lurejewel/-/01小组展示-靳葳部分.pptx

双足机器人设计及分析

汇报人：琚振盟 李江天 张晨曦 范祖鑫 靳葳

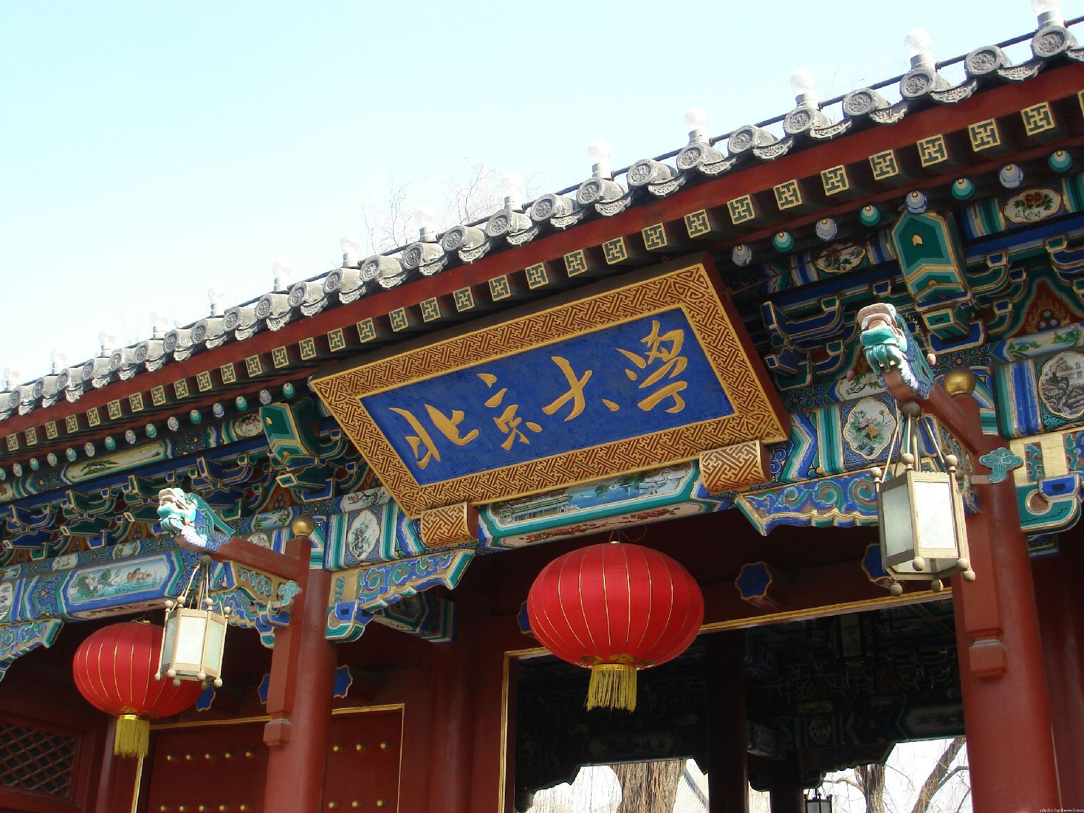
[picture p1: figure]

## Slide 2

- 机械结构设计

- ANASYS强度验证

- 运动学分析仿真

动力学建模

控制策略设计及仿真

## Slide 3

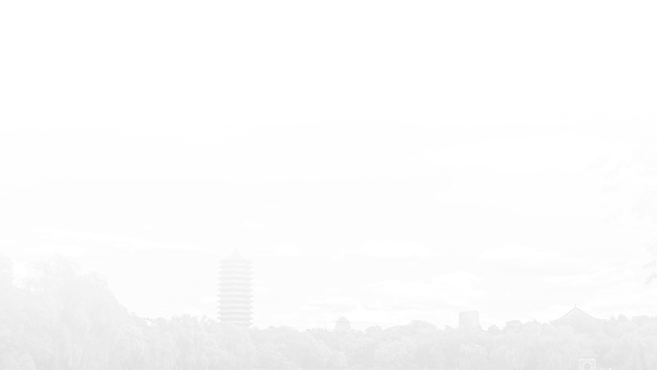
[picture p2: figure]

控制策略设计及仿真

Design of Control Strategy and Simulation

PART 05

## Slide 4

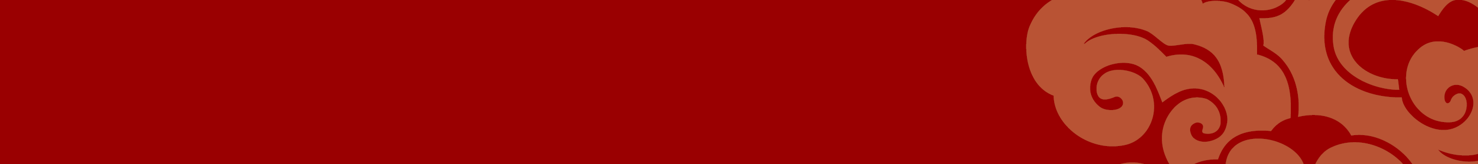
[picture p3: figure]

控制策略设计及仿真

- 基于粒子群参数实时优化的机器人关节轨迹跟踪控制

关节力矩如何给定 ?

- 基于PD的位置跟踪控制

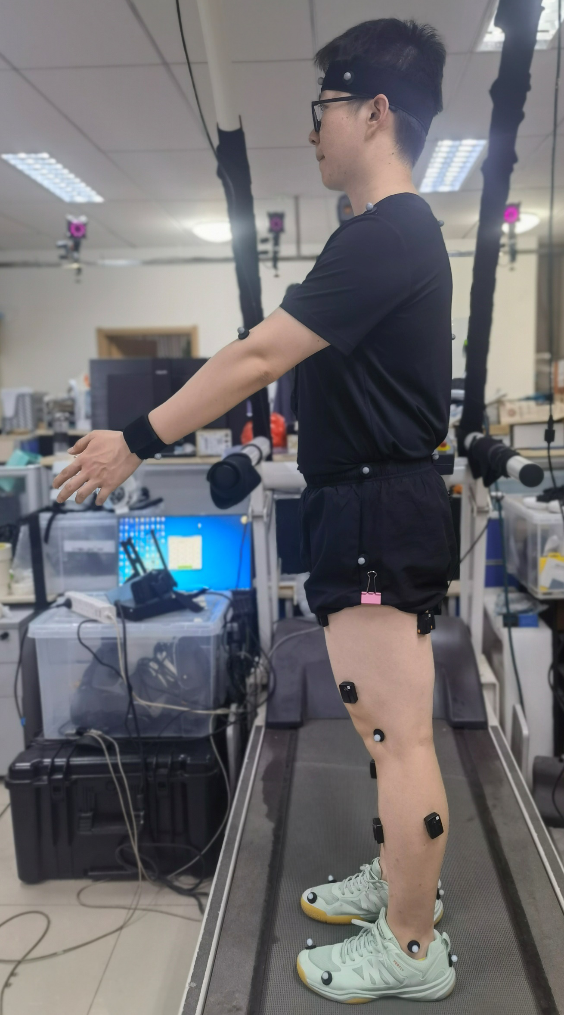
[picture p4: figure]
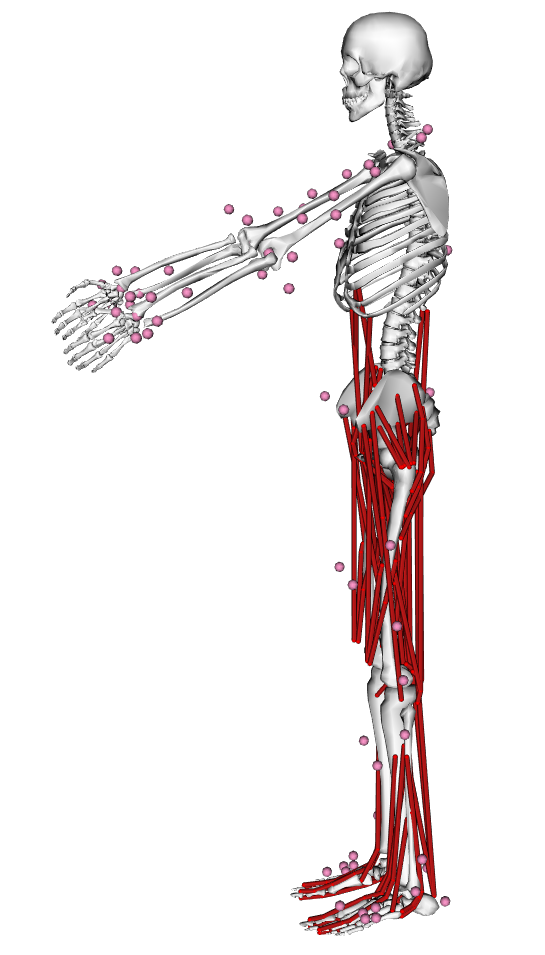
[picture p5: figure]

## Slide 5

解题思路

## 感谢倾听
