lurejewel/-/相关论文、文档参考/去年大作业参考/上肢动力外骨骼康复机器人设计-课程报告-提交版-v2.pdf

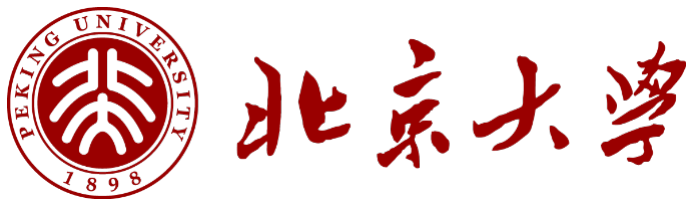
[picture p44: figure]

# 2023 年秋季学期先进机器人控制

# 课程报告

题 目： | 上肢动力外骨骼机器人设计
姓 | 名： 徐明 许诺 朱文铎 王润 孟凡旭
院 | 系： | 工学院先进制造与机器人系

2023 年 12 月

目 录

上肢动力外骨骼机器人设计

## 第 1 章 上肢外骨骼机器人整体方案设计

本章首先从人体解剖学角度分析人体上肢的结构特征与运动规律，然后提出上肢外

骨骼的设计要求。最后，基于这两方面内容确定外骨骼整体设计方案。

### 1.1 人体上肢解剖学分析

结构决定功能。上肢外骨骼机器人的作用对象为人体上肢，分析人体上肢结构，进

而确定其运动规律，对于外骨骼结构设计具有指导意义。本小节主要基于人体解剖学原

理分析人体上肢的骨骼结构与运动规律。

1.1.1 人体上肢结构

上臂

前臂

手部

腕关节

肘关节

肩关节

手指

桡骨 尺骨

肱骨

肱骨头

锁骨
肩锁关节

肩胛骨

图 1-1 人体上肢结构图

人体上肢骨骼结构如图 1-1 所示。自人体远端至人体近端，上肢由手部、前臂、上

臂三部分组成，其中，手部与前臂通过腕关节相连，前臂与上臂通过肘关节相连，上臂

与躯干通过肩关节相连。手部的指骨、前臂的桡骨与尺骨、上臂的肱骨、肩部的肩胛骨

与锁骨是主要的上肢骨骼。

肩关节、肘关节与腕关节是人体上肢的主要关节，本文所设计的外骨骼机器人不涉

及腕关节的运动训练。因此，本文重点讨论肩、肘关节的结构特征与运动规律，分别介

绍如下：

（1）肩关节：肩关节又名盂肱关节，是人体活动范围最大，活动最灵活的关节，由

肱骨头和肩胛骨的关节盂构成，为球窝式关节。肩关节可看作为一个空间球铰机构，肱

骨头绕盂肱关节转动中心有三个旋转自由度。

（2）肘关节：桡骨、尺骨上端与肱骨下端构成肘关节。肘关节为滑车式关节，具有

两个自由度。

1.1.2 人体上肢运动规律

据上文分析可知，人体上肢肩、肘关节具有五个自由度，在日常生活中使用非常频

繁，各自由度详细介绍如下：

肱骨头绕盂肱关节转动中心的三个旋转自由度分别产生上臂外展/内收、前屈/后伸

与外旋/内旋运动，如图 1-2 所示。

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
(a) 肩关节外展/内收 | (b) 肩关节前屈/后伸 | (c) 肩关节外旋/内旋

图 1-2 肩关节运动形式

肘关节的两个自由度分别产生前臂前屈/后伸、外旋/内旋运动，如图 1-3 所示。

旋转轴

前屈
后伸

旋转轴

外旋 | 内旋
(a) 肘关节前屈/后伸 | (b) 肘关节外旋/内旋

图 1-3 肘关节运动形式

此外，由于肩锁关节与胸锁关节的带动作用，在上肢运动过程中肱骨头与肩胛骨的

关节盂构成的肩关节本身会在空间内的三个方向移动，其中，移动幅度以竖直方向为最。

如肩关节在做外展运动时，会伴随着肩胛骨旋转的节律性变化，导致盂肱关节转动中心 在空间内移动，称为肩肱节律[24]。盂肱关节转动中心移动原理如图 1-4 所示。在进行上

肢外骨骼结构设计时应考虑盂肱关节转动中心在空间内的移动。

盂肱关节转动
中心(CR)
CR | CR

图 1-4 盂肱关节转动中心移动原理图

由于控制上肢实现各个运动自由度的骨骼与肌肉结构各不相同，上肢关节各自由度

的运动范围也不同。人体肩、肘关节各自由度的运动范围如表 1-1 所示。表中运动范围

测量的初始姿态为上肢平伸与肩同高，垂直于冠状面，手掌朝内与矢状面平行[25]。其中，

极限运动范围是指人体生理特征所允许的最大运动范围，功能运动范围是指日常生活中

经常用到的运动范围。

表 1-1 人体上肢肩、肘关节运动类型与运动范围

运动类型 | 极限运动范围 | 功能运动范围
肩关节 外展/内收 | 0°~105°/0°~45° | 0°~90°/0°
肩关节 前屈/后伸 | 0°~45°/0°~115° | 0°~30°/0°~90°
肩关节 外旋/内旋 | 0°~50°/0°~80° | 0°~20°/0°~75°
肘关节 前屈/后伸 | 0°~135°/0°~5° | 0°~130°/0°
肘关节 外旋/内旋 | 0°~50°/0°~50° | 0°~50°/0°~50°

### 1.2 上肢外骨骼机器人设计要求

上肢外骨骼机器人是具有特定应用场景的机械装备，为实现其功能，应根据其应用

场景与使用条件制定合理、全面的设计要求，在根本上保证机器人设计的有效性。基于

上文分析结果，现将上肢外骨骼机器人设计要求总结如下：

（1）人-机相容性：上肢外骨骼机器人带动人体上肢运动以实现运动训练，机器人

运动规律应与人体上肢自然运动规律相一致，不能引入超出人体上肢生理范围的运动，

以免对用户造成二次伤害。由于盂肱关节转动中心会在肩锁关节与胸锁关节的带动下做

复杂空间运动，在进行肩关节康复机构设计时应考虑人机相容性要求，使康复机构转动

中心自动适应肩关节转动中心的空间运动，实现关节转动中心“自动对齐”。

（2）普适性：接受上肢运动训练的用户身高、体重等特征往往个体差异较大，而进

行用户个性化设计，生产专用于某类用户的外骨骼机器人会大幅增加成本，不利于产品

推广。因此，应对上肢康复机器人进行普适性设计，研发适用于绝大部分用户的上肢外

骨骼机器人。

（3）轻量化：外骨骼是一种可穿戴式机器人，而患者的承载能力本就显著低于正常

人，这就要求机器人的本体质量应尽可能小，而且应专门设计为患肢提供重量补偿的机

械结构。

（4）安全性：上肢外骨骼机器人直接作用于人体肢体，出现故障时可能引入超出人

体生理范围的运动，轻则对患肢韧带、肌肉等组织造成一定损伤，重则可能造成骨折。

因此，应在机械结构、控制系统等多维度进行安全防护，防止意外情况发生。

### 1.3 上肢外骨骼机器人方案设计

根据人体上肢运动特征与机器人设计要求确定总体设计方案是进行上肢外骨骼机

器人设计的第一步，在整个设计周期内扮演重要角色。首先，本小节将基于上文内容确

定所设计上肢外骨骼的自由度及其分布特征；其次，根据人体上肢测量学数据确定外骨

骼主要结构参数；然后，选择合适的动力源与传动方式；最后，完成肩关节自动对心机

构与重力补偿机构的原理方案设计。

1.3.1 自由度与主要参数确定

本文旨在设计一款为肩、肘关节提供运动训练的上肢动力外骨骼，为达成这一目标，

需设置五个主动自由度，分别对应肩关节外展/内收、前屈/后伸、外旋/内旋与肘关节前

屈/后伸、外旋/内旋运动，如图 1-5 中 J1~J5所示。与此同时，考虑人机相容性要求，应

设置三个移动自由度以适应肩关节转动中心在空间内的运动，如图 1-5 中 P1~P3 所示。

P1~P3 设置为被动型，无动力源驱动，使外骨骼肩关节转动中心被动适应人体肩关节转

动中心，具体实现原理将在本节肩关节自动对心原理部分阐述。为满足普适性设计要求，

设置 P4 与 P5 用于调整杆件长度，这两个自由度在外骨骼工作时被锁定，仅在调整外骨

骼参数时起作用。外骨骼各个主动自由度的运动范围与相应人体关节的功能运动范围一

致。

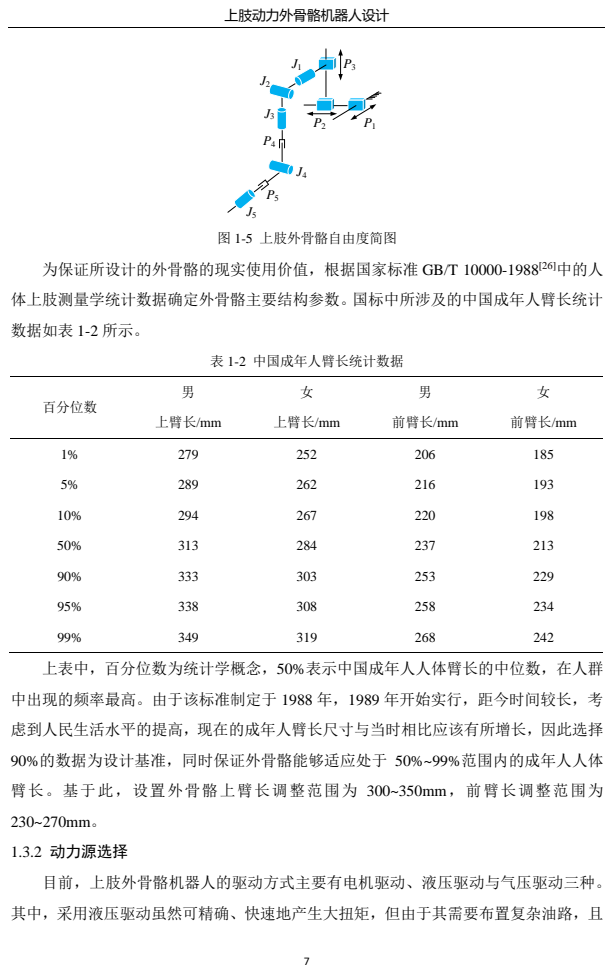
[picture p45: page 8]

为保证所设计的外骨骼的现实使用价值，根据国家标准 GB/T 10000-1988[26]中的人

上表中，百分位数为统计学概念，50%表示中国成年人人体臂长的中位数，在人群

中出现的频率最高。由于该标准制定于 1988 年，1989 年开始实行，距今时间较长，考

其中，采用液压驱动虽然可精确、快速地产生大扭矩，但由于其需要布置复杂油路，且

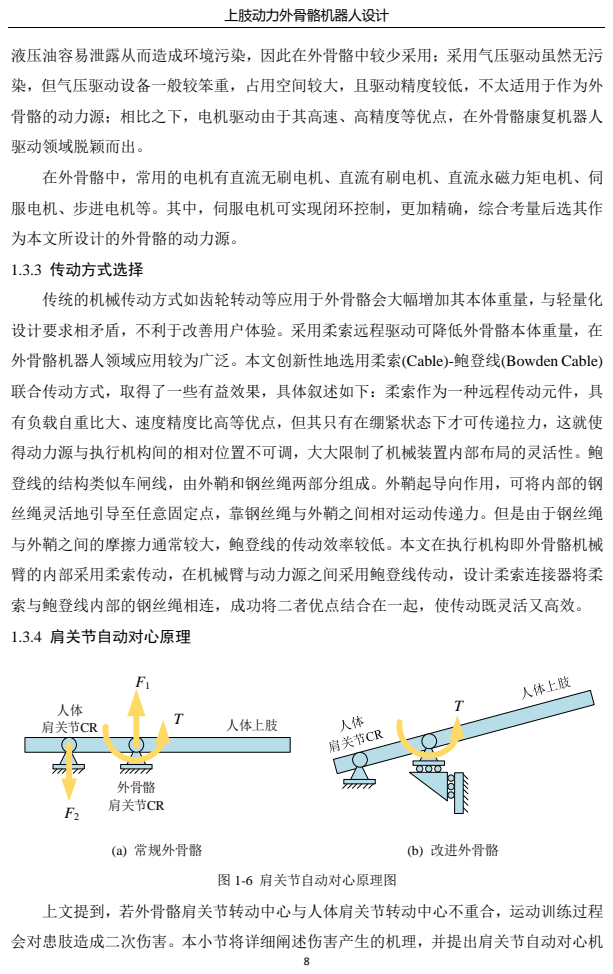
[picture p46: page 9]
驱动领域脱颖而出。; 为本文所设计的外骨骼的动力源。; 1.3.3 传动方式选择; 传统的机械传动方式如齿轮转动等应用于外骨骼会大幅增加其本体重量，与轻量化; 得动力源与执行机构间的相对位置不可调，大大限制了机械装置内部布局的灵活性。鲍; 人体上肢; 人体 肩关节CR; 外骨骼 肩关节CR; (a) 常规外骨骼; (b) 改进外骨骼; 图 1-6 肩关节自动对心原理图

液压油容易泄露从而造成环境污染，因此在外骨骼中较少采用；采用气压驱动虽然无污

染，但气压驱动设备一般较笨重，占用空间较大，且驱动精度较低，不太适用于作为外

骨骼的动力源；相比之下，电机驱动由于其高速、高精度等优点，在外骨骼康复机器人

在外骨骼中，常用的电机有直流无刷电机、直流有刷电机、直流永磁力矩电机、伺

服电机、步进电机等。其中，伺服电机可实现闭环控制，更加精确，综合考量后选其作

设计要求相矛盾，不利于改善用户体验。采用柔索远程驱动可降低外骨骼本体重量，在
外骨骼机器人领域应用较为广泛。本文创新性地选用柔索(Cable)-鲍登线(Bowden Cable)

联合传动方式，取得了一些有益效果，具体叙述如下：柔索作为一种远程传动元件，具

有负载自重比大、速度精度比高等优点，但其只有在绷紧状态下才可传递拉力，这就使

登线的结构类似车闸线，由外鞘和钢丝绳两部分组成。外鞘起导向作用，可将内部的钢

丝绳灵活地引导至任意固定点，靠钢丝绳与外鞘之间相对运动传递力。但是由于钢丝绳

与外鞘之间的摩擦力通常较大，鲍登线的传动效率较低。本文在执行机构即外骨骼机械

臂的内部采用柔索传动，在机械臂与动力源之间采用鲍登线传动，设计柔索连接器将柔

索与鲍登线内部的钢丝绳相连，成功将二者优点结合在一起，使传动既灵活又高效。
1.3.4 肩关节自动对心原理

上文提到，若外骨骼肩关节转动中心与人体肩关节转动中心不重合，运动训练过程

会对患肢造成二次伤害。本小节将详细阐述伤害产生的机理，并提出肩关节自动对心机

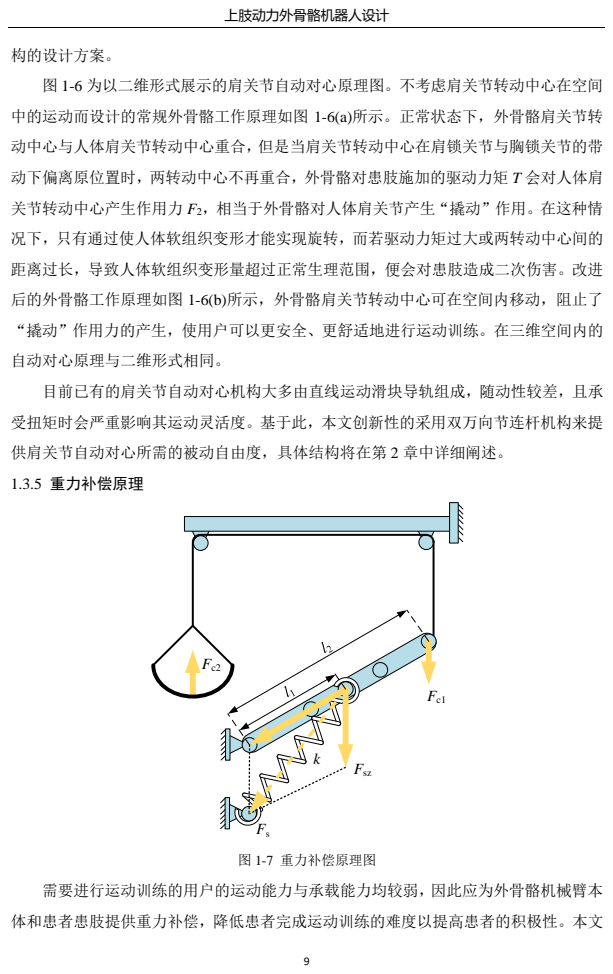
[picture p47: page 10]
构的设计方案。; 图 1-6 为以二维形式展示的肩关节自动对心原理图。不考虑肩关节转动中心在空间; 自动对心原理与二维形式相同。; 1.3.5 重力补偿原理; Fsz; 图 1-7 重力补偿原理图; 需要进行运动训练的用户的运动能力与承载能力均较弱，因此应为外骨骼机械臂本

中的运动而设计的常规外骨骼工作原理如图 1-6(a)所示。正常状态下，外骨骼肩关节转

动中心与人体肩关节转动中心重合，但是当肩关节转动中心在肩锁关节与胸锁关节的带
动下偏离原位置时，两转动中心不再重合，外骨骼对患肢施加的驱动力矩 T 会对人体肩

关节转动中心产生作用力 F2，相当于外骨骼对人体肩关节产生“撬动”作用。在这种情

况下，只有通过使人体软组织变形才能实现旋转，而若驱动力矩过大或两转动中心间的

距离过长，导致人体软组织变形量超过正常生理范围，便会对患肢造成二次伤害。改进
后的外骨骼工作原理如图 1-6(b)所示，外骨骼肩关节转动中心可在空间内移动，阻止了

“撬动”作用力的产生，使用户可以更安全、更舒适地进行运动训练。在三维空间内的

目前已有的肩关节自动对心机构大多由直线运动滑块导轨组成，随动性较差，且承

受扭矩时会严重影响其运动灵活度。基于此，本文创新性的采用双万向节连杆机构来提
供肩关节自动对心所需的被动自由度，具体结构将在第 2 章中详细阐述。

体和患者患肢提供重力补偿，降低患者完成运动训练的难度以提高患者的积极性。本文

所采用的重力补偿机构原理如图 1-7 所示。图中，弹簧的弹性系数为 k，变形量为 x，Fs

为弹簧力，Fsz 为弹簧力在竖直方向的分量，l1、l2 为杆件长度，Fc1、Fc2 为补偿力。由图

1-7 中所示几何关系，可得到式(1-1)、式(1-2)与式(1-3)。可通过改变 l1 的长度调节补偿

力的大小。

F kx s = | (1-1)

sz 1
c1
2

### Fl F

l = | (1-2)
FF c2 | c1 = | (1-3)

## 第 2 章 上肢外骨骼机器人机械结构设计

在第 1 章中只确定了外骨骼设计的原理方案，并未涉及具体机械结构的设计。本章

将承接第 1 章所讨论的外骨骼整体设计方案，完成机器人主体结构设计，并利用

## SOLIDWORKS 软件绘制三维模型。

### 2.1 外骨骼机器人结构设计

本文所设计的上肢外骨骼机器人主要由机械臂模块、肩关节自动对心模块、重力补

偿模块、动力源模块与座椅、支架等组成，整体装配效果如图 2-1 所示。本小节将分别

介绍每个模块的结构组成与装配关系。

重力补偿
模块

机械臂
模块

肩关节自动
对心模块

动力源
模块

图 2-1 外骨骼机器人整体结构图

## 2.1.1 机械臂模块

机械臂模块是本文所述的外骨骼机器人的核心模块，其直接与人体上肢相接触，是

整个机器人的执行机构。该模块由肩关节运动模块与肘关节运动模块两部分组成。

（1）肩关节运动模块：

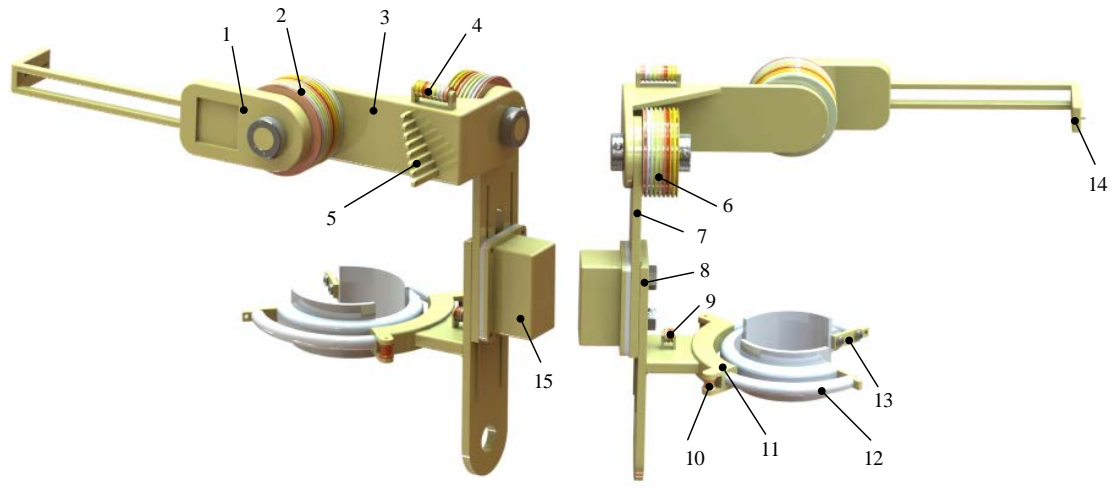
[picture p48: figure]

1 小肩板；2 滑轮组 A；3 大肩板；4 导向轮组；5 导向孔组；6 滑轮组 B；7 上臂板_固定；

8 上臂板_滑动；9 大导向轮组 A；10 小导向轮 A；11 上臂环_固定；12 上臂环_滑动；13 小垫板；

14 鲍登线固定端 A；15 螺栓罩

图 2-2 肩关节运动模块结构图

肩关节运动模块结构如图 2-2 所示，滑轮组 A(2)与小肩板(1)安装在大肩板(3)一端

的轴上，利用轴端挡圈与锁紧螺钉定位。小肩板(1)一侧设计有鲍登线固定端 A(14)，用

于固定鲍登线外鞘。滑轮组 A(2)由 9 个滑轮组成，自靠近小肩板(1)的一侧开始依次为滑

轮组 A_1 至滑轮组 A_9。其中，滑轮组 A_9 为驱动滑轮，其上有两个绳槽，滑轮通过

键与轴相连，可传递动力；其余为浮动滑轮，均只有一个绳槽，空套在轴上，只起导向

作用。大肩板(3)上设计有导向孔组(5)与导向轮支架，导向轮支架上安装有导向轮组(4)。

导向孔组(5)由 8 个导向孔组成，自靠近导向轮组(4)的一侧开始依次为导向孔_1 至导向

孔_8。导向轮组(4)由 8 个导向轮组成，自靠近滑轮组 A(2)的一侧开始依次为导向轮_1

至导向轮_8。大肩板(3)的无轴端设计有轴孔，与上臂板_固定(7)一端的短轴配合，依靠

轴端挡圈与锁紧螺钉定位。上臂板_固定(7)一端的长轴上安装有滑轮组 B(6)，利用轴端

挡圈与锁紧螺钉定位。滑轮组 B(6)由 7 个滑轮组成，自靠近大肩板(3)的一侧开始依次为

滑轮组 B_1 至滑轮组 B_7。其中，滑轮组 B_7 为驱动滑轮，其上有两个绳槽，滑轮通过

键与轴相连，可传递动力；其余为浮动滑轮，均只有一个绳槽，空套在轴上，只起导向

作用。上臂板_固定(7)上开有尺寸调整槽，两个螺栓穿过尺寸调整槽将上臂板_固定(7)与

上臂板_滑动(8)连接在一起，两者间的竖直相对位置可调。螺栓罩(15)将两个螺栓的露出

端遮挡起来，防止刮伤操作者。上臂板_滑动(8)下部固连有上臂环_固定(11)，上臂环_固

定(11)上安装有大导向轮组 A(9)与小导向轮 A(10)。大导向轮组 A(9)由两个大导向轮组

成，均位于上臂环_固定(11)的对称面上，两个小导向轮 A(10)在上臂环_固定(11)两侧对

称分布。上臂环_固定(11)与上臂环_滑动(12)的圆环面配合，上臂环_滑动(12)可沿上臂

环_固定(11)内槽滑动。上臂环_滑动(12)分内外两部分，小垫板(13)与螺钉将二者固连在

一起，上臂环_滑动(12)内侧贴附有气垫，充气后与人体上臂紧密贴合。上臂板_固定(7)

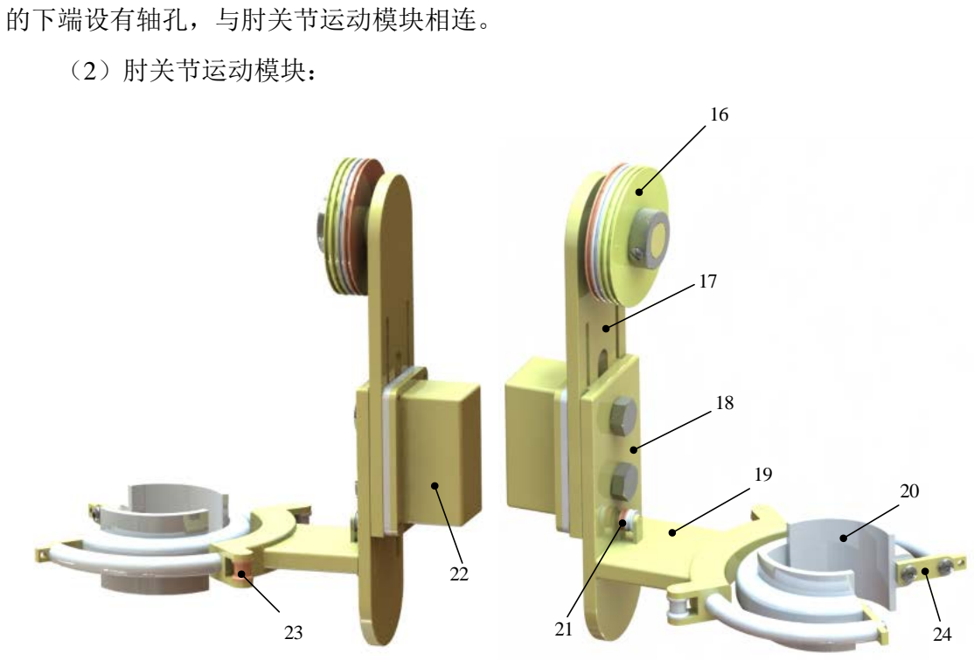
[picture p49: figure]
的下端设有轴孔，与肘关节运动模块相连。; （2）肘关节运动模块：

16 滑轮组 C；17 前臂板_固定；18 前臂板_滑动；19 前臂环_固定；20 前臂环_滑动；21 大导向轮组 B；

22 螺栓罩；23 小导向轮 B；24 小垫板

图 2-3 肘关节运动模块结构图

肘关节运动模块结构如图 2-3 所示，滑轮组 C(16)、上臂板_固定(7)的轴孔与前臂板

_固定(17)一端的轴配合，利用轴端挡圈与锁紧螺钉定位。滑轮组 C(16)由 3 个滑轮组成，

自靠近前臂板_固定(17)的一侧开始依次为滑轮组 C_1 至滑轮组 C_3。其中，滑轮组 C_3

为驱动滑轮，其上有两个绳槽，滑轮通过键与轴相连，可传递动力；其余为浮动滑轮，

均只有一个绳槽，空套在轴上，只起导向作用。前臂板_固定(17)上开有尺寸调整槽，两

个螺栓穿过尺寸调整槽将前臂板_固定(17)与前臂板_滑动(18)连接在一起，两者间的竖

直相对位置可调。螺栓罩(22)将两个螺栓的露出端遮挡起来，防止刮伤操作者。前臂板

_滑动(18)下部固连有前臂环_固定(19)，前臂环_固定(19)上安装有大导向轮组 B(21)与小

导向轮 B(23)，大导向轮组 B(21)由两个大导向轮组成，均位于前臂环_固定(19)的对称面

上，两个小导向轮 B(23)在前臂环_固定(19)两侧对称分布。前臂环_固定(19)与前臂环_

滑动(20)的圆环面配合，前臂环_滑动(20)可沿前臂环_固定(19)内槽滑动。前臂环_滑动

(20)分内外两部分，小垫板(24)与螺钉将二者固连在一起，前臂环_滑动(20)内侧贴附有

气垫，充气后与人体前臂紧密贴合。

2.1.2 肩关节自动对心模块

肩关节自动对心模块为双万向节连杆机构，结构如图 2-4 所示。连杆 A(25)一端与

小肩板(1)固连，另一端通过十字轴 A(26)与连杆 B(27)的一端连接在一起，连杆 B(27)的

另一端通过十字轴 B(28)与连杆 C(29)的一端相连，连杆 C(29)的另一端固定在支架上。

连杆 C(29)与支架相连的一端为整个机构的固定端，连杆 A(25)与小肩板(1)相连的一端

为机构末端。其末端工作空间为两球面所夹区域，半径由连杆 A(25)与连杆 B(27)的长度

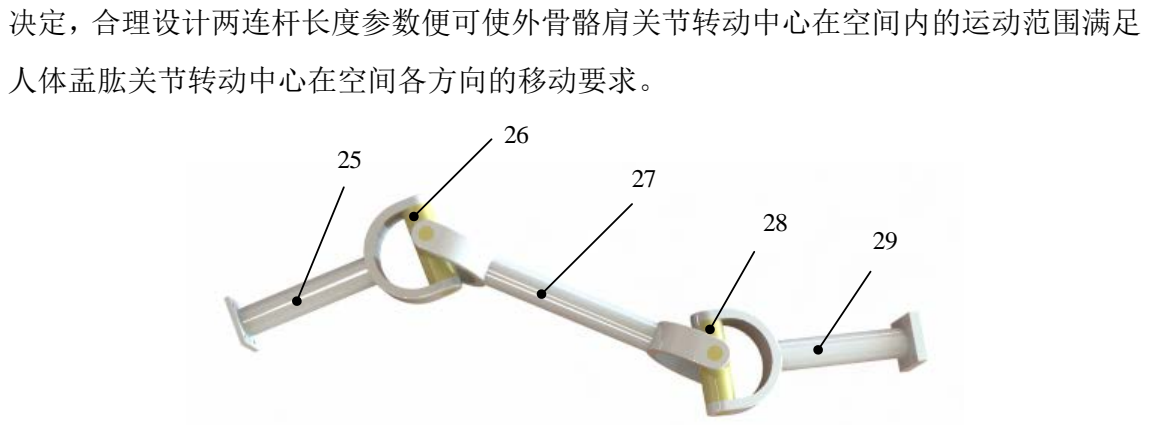
[picture p50: figure]
决定，合理设计两连杆长度参数便可使外骨骼肩关节转动中心在空间内的运动范围满足; 人体盂肱关节转动中心在空间各方向的移动要求。

25 连杆 A；26 十字轴 A；27 连杆 B；28 十字轴 B；29 连杆 C

图 2-4 肩关节自动对心模块结构图

2.1.3 重力补偿模块

重力补偿模块结构如图 2-5 所示，重力补偿杆(31)一端与支架(32)铰接，另一端设计

有柔索固定环。弹簧(30)一端固定在支架(32)上，另一端与重力补偿杆(31)上的卡槽之一

相连。大滑轮 A(33)与大滑轮 B(34)安装在支架(32)上。柔索一端固定在重力补偿杆(31)

的柔索固定环上，经大滑轮 A(33)与大滑轮 B(34)导向后与小肩板(1)相连，通过弹簧变

形产生的拉力为外骨骼提供重力补偿。

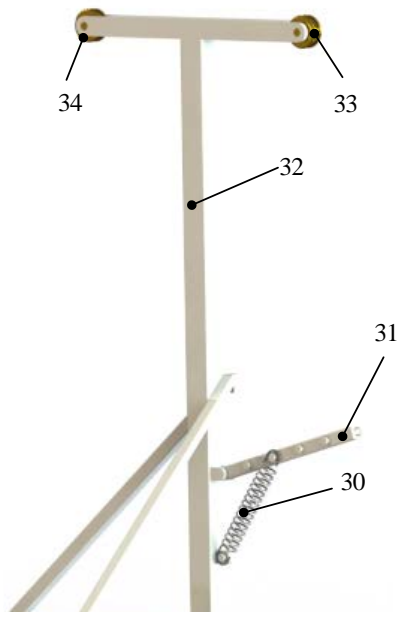
[picture p51: figure]

30 弹簧；31 重力补偿杆；32 支架；33 大滑轮 A；34 大滑轮 B

图 2-5 重力补偿模块结构图

## 2.1.4 动力源模块

动力源模块共有五组，平行布置安装在支架(32)上，结构均如图 2-6 所示。伺服电

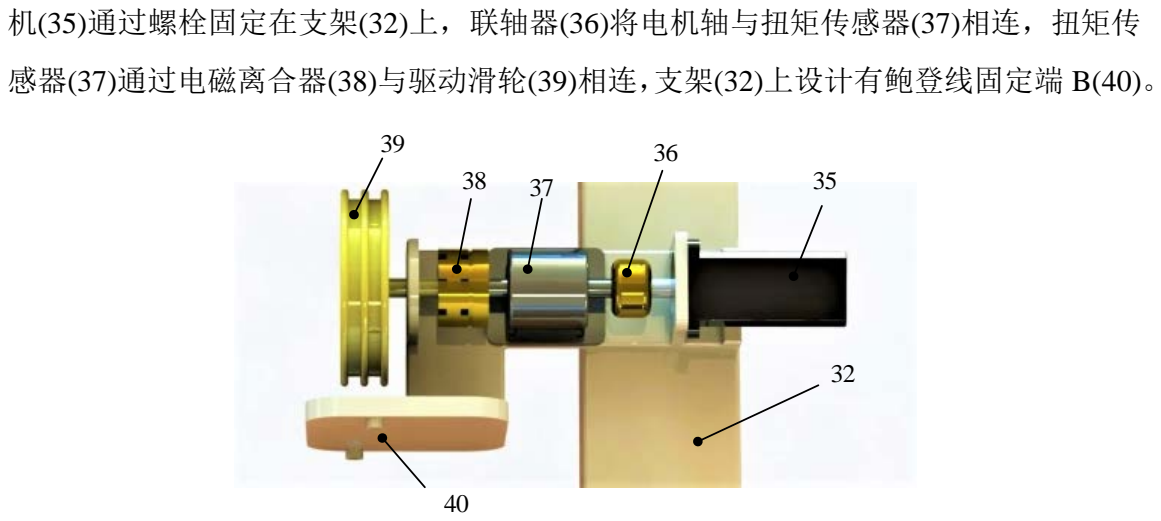
[picture p52: figure]
机(35)通过螺栓固定在支架(32)上，联轴器(36)将电机轴与扭矩传感器(37)相连，扭矩传; 感器(37)通过电磁离合器(38)与驱动滑轮(39)相连，支架(32)上设计有鲍登线固定端 B(40)。

32 支架；35 伺服电机；36 联轴器；37 扭矩传感器；38 电磁离合器；39 驱动滑轮；40 鲍登线固定端 B

图 2-6 动力源模块结构图

2.1.5 机器人整体装配效果

上肢外骨骼机器人整体装配效果如图 2-7 所示。

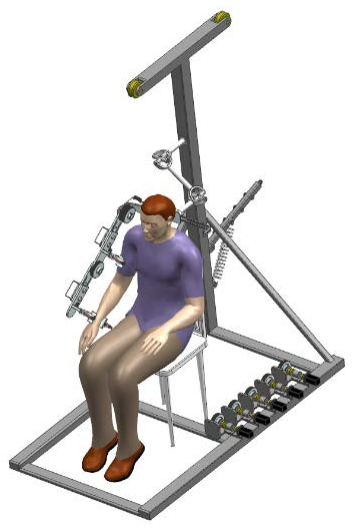
[picture p53: figure]
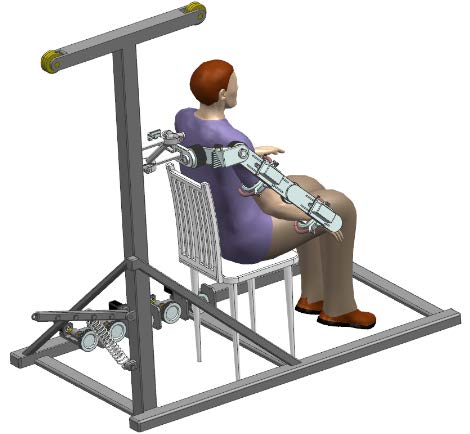
[picture p54: figure]

图 2-7 机器人整体装配效果图

### 2.2 传动策略与实施方式

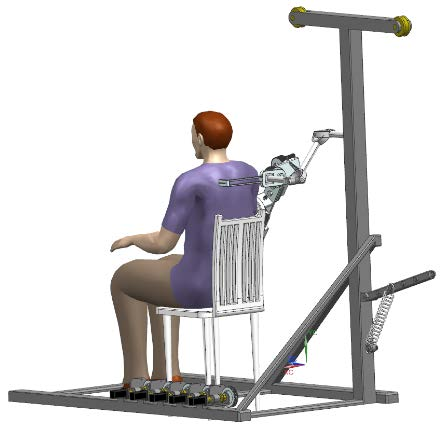
[picture p55: figure]

本文所设计的上肢外骨骼采用柔索-鲍登线联合传动，柔索与鲍登线内部的钢丝绳

直径不同，因此需设计柔索连接器将二者相连。柔索连接器结构如图 2-8 所示，鲍登线

内部钢丝绳(41)与柔索(45)末端分别装有大卡环(42)与小卡环(44)，利用两个连接挡板(46)

和四个螺钉将大卡环(42)与小卡环(44)分别固定在连接架(43)的两端。柔索连接器在装配

体中位于滑轮组 A(2)与鲍登线固定端 A(14)之间。

42 41

43

44
45

46

41 鲍登线内部钢丝绳；42 大卡环；43 连接架；44 小卡环；45 柔索；46 连接挡板

图 2-8 柔索连接器结构图

该外骨骼具有五个主动自由度，而柔索与鲍登线均单向提供拉力，因此需要十根柔

索与十根鲍登线传动，分别驱动外骨骼的五个主动关节正反旋转。根据各关节提供运动

训练形式的不同，分以下五部分介绍传动装置的布置与具体实施方式。

（1）肩关节外展/内收训练：滑轮组 A_9 的两个绳槽上分别固连有一根柔索，两根

柔索通过柔索连接器分别与两根鲍登线内部的钢丝绳相连，鲍登线外鞘的一端固定在鲍

登线固定端 A(14)处，另一端固定在第一组动力源的鲍登线固定端 B(40)处，两根鲍登线

内部钢丝绳在外鞘的引导下分别与该组动力源的驱动滑轮(39)上的两个绳槽相连，该组

动力源的伺服电机(35)正反转时分别实现肩关节外展与内收训练。

（2）肩关节前屈/后伸训练：滑轮组 B_7 的两个绳槽上分别固连有一根柔索，其中

一根柔索经导向轮_1、导向孔_1 与滑轮组 A_1 导向后通过柔索连接器与一根鲍登线内

部的钢丝绳相连；另一根柔索经导向轮_2、导向孔_2 与滑轮组 A_2 导向后通过柔索连

接器与另一根鲍登线内部的钢丝绳相连；鲍登线外鞘的一端固定在鲍登线固定端 A(14)

处，另一端固定在第二组动力源的鲍登线固定端 B(40)处，两根鲍登线内部钢丝绳在外

鞘的引导下分别与该组动力源的驱动滑轮(39)上的两个绳槽相连，该组动力源的伺服电

机(35)正反转时分别实现肩关节前屈与后伸训练。

（3）肩关节内旋/外旋训练：上臂环_滑动(12)上的两个小垫板(13)上分别固定有一

根柔索，其中一根柔索经小导向轮 A(10)、大导向轮 A(9)、滑轮组 B_6、导向轮_3、导

向孔_3 与滑轮组 A_3 导向后通过柔索连接器与一根鲍登线内部的钢丝绳相连；另一根

柔索经小导向轮 A(10)、大导向轮 A(9)、滑轮组 B_5、导向轮_4、导向孔_4 与滑轮组 A_4

导向后通过柔索连接器与另一根鲍登线内部的钢丝绳相连；鲍登线外鞘的一端固定在鲍

登线固定端 A(14)处，另一端固定在第三组动力源的鲍登线固定端 B(40)处，两根鲍登线

内部钢丝绳在外鞘的引导下分别与该组动力源的驱动滑轮(39)上的两个绳槽相连，该组

动力源的伺服电机(35)正反转时分别实现肩关节内旋与外旋训练。

（4）肘关节前屈/后伸训练：滑轮组 C_3 的两个绳槽上分别固连有一根柔索，其中

一根柔索经滑轮组 B_4、导向轮_5、导向孔_5 与滑轮组 A_5 导向后通过柔索连接器与

一根鲍登线内部的钢丝绳相连；另一根柔索经滑轮组 B_3、导向轮_6、导向孔_6 与滑轮

组 A_6 导向后通过柔索连接器与另一根鲍登线内部的钢丝绳相连；鲍登线外鞘的一端

固定在鲍登线固定端 A(14)处，另一端固定在第四组动力源的鲍登线固定端 B(40)处，两

根鲍登线内部钢丝绳在外鞘的引导下分别与该组动力源的驱动滑轮(39)上的两个绳槽相

连，该组动力源的伺服电机(35)正反转时分别实现肘关节前屈与后伸训练。

（5）肘关节内旋/外旋训练：前臂环_滑动(20)上的两个小垫板(24)上分别固定有一

根柔索，其中一根柔索经小导向轮 B(23)、大导向轮 B(21)、滑轮组 B_2、导向轮_7、导

向孔_7 与滑轮组 A_7 导向后通过柔索连接器与一根鲍登线内部的钢丝绳相连；另一根

柔索经小导向轮 B(23)、大导向轮 B(21)、滑轮组 B_1、导向轮_8、导向孔_8 与滑轮组

A_8 导向后通过柔索连接器与另一根鲍登线内部的钢丝绳相连；鲍登线外鞘的一端固定

在鲍登线固定端 A(14)处，另一端固定在第五组动力源的鲍登线固定端 B(40)处，两根鲍

登线内部钢丝绳在外鞘的引导下分别与该组动力源的驱动滑轮(39)上的两个绳槽相连，

该组动力源的伺服电机(35)正反转时分别实现肘关节内旋与外旋训练。

## 第 3 章 机械臂运动学分析与仿真

运动学分析是不考虑力和力矩对机构的影响，仅在几何角度分析机械结构运动特性

的研究方法，是机器人可行性验证的重要环节。机器人运动学分析分为正运动学分析与

逆运动学分析两部分。其中，正运动学分析是指已知机器人各关节运动参数，求解机器

人末端执行器的位置和姿态；与之相反，逆运动学分析是已知末端位置和姿态进而求解 达到这一位置和姿态时各关节的运动参数[27]。本文利用 1955 年 Denavit 与 Hartenberg 提

出的标准 D-H 参数法进行上肢外骨骼机械臂正、逆运动学理论分析，并借助 MATLAB

Robotics Toolbox 完成仿真验证。人体盂肱关节转动中心在空间的移动范围与人体上肢

的活动范围相比很小，可以忽略不计，因此，在本章及后面的章节中仅以外骨骼机械臂

为研究对象，忽略肩关节自动对心机构的影响。

### 3.1 运动学理论分析

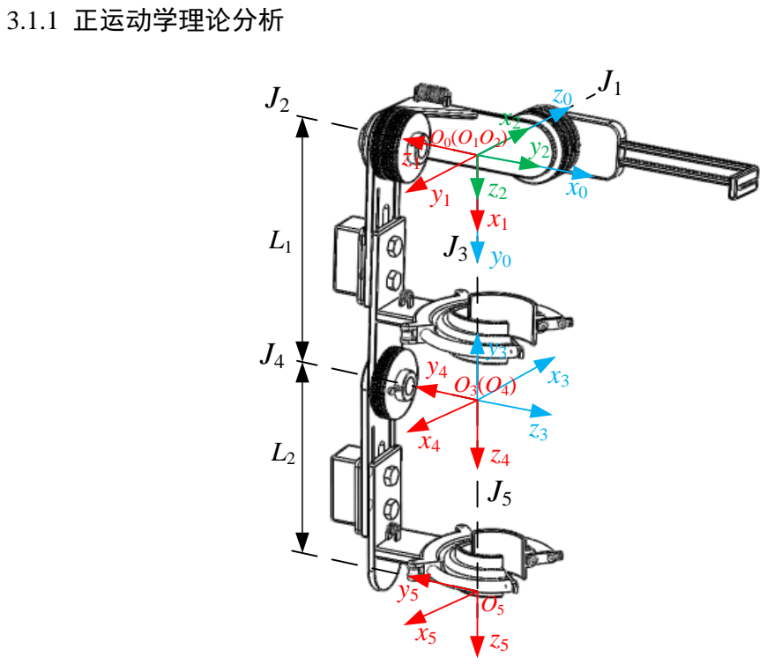
[picture p56: figure]
3.1.1 正运动学理论分析 J1 J2

图 3-1 机器人 D-H 坐标系

首先，基于 D-H 参数法建立如图 3-1 所示的坐标系。其中，{0}系为基座坐标系，

{1}至{4}系为关节坐标系，{5}系为末端工具坐标系；{0}系、{1}系与{2}系的坐标原点

均位于肩关节转动中心处，{3}系与{4}系的坐标原点位于肘关节转动中心处，{5}系的坐

标原点位于腕关节转动中心处；J1~J5 为机械臂的五个旋转轴，依次对应肩关节外展/内

收、前屈/后伸、外旋/内旋与肘关节前屈/后伸、外旋/内旋训练；L1为机械臂上臂长，L2

为机械臂前臂长。

根据标准 D-H 参数法坐标系建立原则，{i}系是由{i-1}系先绕 zi-1 轴旋转θi，再沿 zi-

1 轴平移 di，然后沿 xi轴平移 ai，最后绕 xi 轴旋转αi 得到的。因此，从{i-1}系到{i}系的

齐次变换矩阵如式(3-1)所示。
1 | Rot( , )Trans( , )Trans( , )Rot( , ) 1 | 1
00100 0 100 | 1 0 | 0 0
00010 0 010 0 0 | 0
0 | 0 10001 | 001 0 0 | 0
0 | 0 01000 1 000 1 0 0 | 0 1

i
i | i | i | i | i | i | i | i | i
i | i | i
i | i | i
i | i | i
i | i | i | i
z | z d | xa | x
c | s | a
s | c | c | s
d | s | c
c | cs | s
θ | α
θ | θ
θ | θ | α | α
| | α | α
θ | αθ α
− | = | − | −
- | − | | | | | | | | − = | | | | | | | | | | | | | | | |

−

=

T

0
0 | 0 | 0 | 1
i | i | i
i | i | i | i | i | i | i
i | i
| | | s | | ac
s | c c | s c | as
s | c | d
| | | | θ | | θ
θ αθ | αθ | θ
| α | | α
- −

(3-1)

上式中，θi 表示关节转角，di 表示关节偏移，ai 表示杆件长度，αi 表示杆件扭角，

sθi =sinθi，cθi =cosθi。为简化矩阵，下文均用 sθi 代表 sinθi, cθi 代表 cosθi。

然后，根据各坐标系之间的关系与机械臂结构设计参数确定 D-H 参数表，如表 3-1

所示。其中，括号内的数据为机器臂处于图 3-1 所示状态时的关节转角θi 的取值。

将表 3-1 所示数据代入式(3-1)可得到相邻坐标系间的齐次变换矩阵，如式(3-2)所示。

2

1 | 1 | 2 | 2
0 | 1 1 | 1 | 2
1 | 2
3 | 3 | 4 | 4
2 | 3 3 | 3 | 4 | 4
3 | 4
1
| 5 | 5
4 | 5 | 5
5
2
0 | | 0 | 0 | 0
0 | | 0 | 0 | 0
0 | 100 | 0 | 100
00 | 01 | 00 | 01
0 | | 0 | 0 | 0
0 | | 0 | 0 | 0
0 | 10 | 0 | 100
00 | 0 | 1 | 00 | 01
| | | 00
| | | 00
0 | 01
0 | 00
c | s | c | s
s | c | s | c
c | s | c | s
s | c | s | c
L
c | s
s | c
L
θ | θ | θ | θ
θ | θ | θ | θ
θ | θ | θ | θ
θ | θ | θ | θ
θ | θ
θ | θ
- | − | | −
= | = − | −
- | − | − | | | | |
= | | = | | − | − | | | | | | | |

−

=

T T

T T

T
1

(3-2)

表 3-1 机器人 D-H 参数表

杆件 i | 关节转角θi | 关节偏移 di | 杆件长度 ai | 杆件扭角αi | θi 变化范围
1 | θ1(90°) | 0 | 0 | -90° | 90°~210°
2 | θ2(-90°) | 0 | 0 | -90° | -120°~0°
3 | θ3(0°) | L1 | 0 | -90° | -75°~20°
4 | θ4(180°) | 0 | 0 | -90° | 50°~180°
5 | θ5(0°) | L2 | 0 | 0 | -50°~50°

根据矩阵的性质，由式(3-2)可求得从基坐标系{0}系到末端工具坐标系{5}系的齐次

变换矩阵 0

## T5，如式(3-3)所示。

0 | 01 | 2 | 3 | 4
5 | 12 | 3 | 4 | 5
0001
x | x | x | x
y | y | y | y
z | z | z | z

### noa p noa p noa p

= | = |
T TT T T T | (3-3)

上式中：
( ( | ) | ) | ( | )
( | ) | ( ( | ) | )
( | )
( ( | ) | ) | ( | )
5 | 4 | 13 | 12 3 | 12 4 | 5 | 31 | 123
5 | 13 | 213 | 5 | 4 | 13 | 2 31 | 12 4
5 | 24 | 342 | 235
5 | 4 | 13 | 12 3 | 12 4 | 5 | 31 | 123

x

y

z

x

y

n c c ss | ccc | cs s | s cs | cc s
n s cc | c ss | c c cs | ccs | ss s
n c cs | ccs | sss
o | s c ss | ccc | cs s | c cs | cc s
o
θ θ θθ θθ θ | θθ θ | θ θθ θθ θ
θ θθ θ θθ | θ θ θθ θ θθ | θθ θ
θ θθ θθθ | θθθ
θ θ θθ θθ θ | θθ θ | θ θθ θθ θ
= | + | + | − | −
= | + | − | − | −
= | − | −
=− | + | + | − | −
( ( | ) | ) | ( | )
( | )
( | )
( | )
( | )
5 | 4 | 13 | 2 31 | 12 4 | 5 | 13 | 213
5 | 24 | 342 | 523
142 | 4 | 13 | 123
4 | 13 | | 2 31 | 412
2 | 4 | 324
2 | 4 | 13 | 123 | 1

z

x

y

z

x

s c cs | ccs | ss s | c cc | c ss
o | s cs | ccs | css
a cc s | s ss | ccc
a s cs | ccs | css
a cc | css
p | L s ss | ccc | cc
θ θ θθ θ θθ | θθ θ | θ θθ θ θθ
θ θθ θθθ | θθθ
θθ θ θ θθ θθ θ
θ θθ θ θθ θ θθ
θθ θθθ
θ θθ θθ θ | θθ
= | − | − | + | +
=− | − | −
= | − | +
= | − | +
= | +
=− | + | − ( | )
( ( | ) | )
( | )
| | | | 4 2 | 112
2 | 4 | 13 | 2 31 | 412 | 112
2 | 2 | 4 | 324 | 12

y

z

s | Lc s
p L s c s | c c s | c s s | Ls s
p L c c | c s s | Lc
θ | θθ
θ θθ θ θθ | θ θθ | θθ
θθ θθθ | θ
| | | −
= | − | + | −
= | + | −

当机械臂处于图 3-1 所示状态时，关节转角向量θ = [90°,-90°,0°,180°,0°]，代入式(3-

3)可求得如式(3-4)所示的末端姿态矩阵。

1 | 2
0 | 10 | 0
0 01
100 | 0
0 00 | 1
| | L L
- −
- + = −

T (3-4)

根据第 1 章机械臂结构设计参数可知，在图 3-1 所示姿态下，L1=350mm，L2=270mm，

且 L1 与 L2 可根据用户上肢长度在一定范围内调整。

3.1.2 逆运动学理论分析

逆运动学分析是正运动学分析的逆过程，在机器人学中占有重要地位，直接影响着

机器人控制的准确性与快速性。目前，逆运动学求解方法主要有迭代法、几何法与反变

换法三种。其中，迭代法的计算量很大，而几何法仅适用于自由度较少的情况，因此，

本文选用 1981 年 Paul 等人提出的反变换法进行逆运动学求解。反变换法的基本原理是

用未知的逆变换逐次左乘末端工具坐标系相对于基坐标系的齐次变换矩阵，将各个关节

变量分离求解。

由矩阵的性质可将式(3-3)变形为：

4 | 10 | 0
5 | 5 | 4 ()⁻ T | TT = | (3-4)

求解式(3-4)等号左边部分：

| | 5 | 5
4 | 10 | 5 | 5
5 | 5
2

00
00
() | 0 | 01
0 | 001 | 0001
x | x | x | x
y | y | y | y
z | z | z | z
c | s | noa p
s | c | noa p
| | Lnoa p
θ | θ
θθ −
- | | | | − = | | | − | | | | |
T | T | (3-5)

求解式(3-4)等号右边部分：

| | | | 1 | 1 | 1 | 1
| | | | 1 | 1 | 1 | 1
0 | 01 | 2 | 3
4 | 12 | 3 | 4 | 1 | 1 | 1 | 1
0 | 0 | 0 | 1
x | x | x | x
y | y | y | y
z | z | z | z
n | o | a | p
n | o | a | p
n | o | a | p
= | =
T | TT T T | (3-6)

（1）求解θ2：由式(3-4)等号两边矩阵元素(3, 4)对应相等，可得：

1
2 | 1 | 2 cos z | z pL | p | L − = | =− | θ | (3-7)

解得：

2
2
1

### arccos( ) Lpz

L

θ | − = | (3-8)

由上式可知：θ2 有唯一解。

（2）求解θ3：由式(3-4)等号两边矩阵元素(3, 2)对应相等，可得：

1
2 | 3 sin sin z | z o | o = | = − θθ | (3-9)

解得：

3
2 | 2

1

### arcsin

1( )

z

z

o
Lp
L
θ = ± | − −
(3-10)

由上式可知：θ3 有互为相反数的两个解。

由矩阵的性质还可将式(3-3)变形为：

3 | 4 | 10 | 0
4 | 5 | 5 | 3 ( | )⁻ TT | T T = | (3-11)

求解式(3-11)等号左边部分：

| | | 45 | 54 | 5
3 | 4 | 10 | 45 | 45 | 5
4 | 5 | 5
4 | 4 | 2

0
0
( | ) | 0
0 | 0 | 0 | 1 | 0001
x | x | x | x
y | y | y | y
z | z | z | z
cc | cs | s | n o a p
cs | ss | c | n o a p
s | c | | Lnoa p
θθ | θθ | θ
θθ | θθ | θ
θ | θ

−

- | − | | | | − | − | − = | | − | − | | | | |
TT | T | (3-12)

求解式(3-11)等号右边部分：

| 2 | 2 | 2 | 2
| 2 | 2 | 2 | 2
0
3 | 2 | 2 | 2 | 2
0 | 0 | 0 | 1
x | x | x | x
y | y | y | y
z | z | z | z
n | o | a | p
n | o | a | p
n | o | a | p
=

T (3-13)

（3）求解θ4：由式(3-11)等号两边矩阵元素(3, 4)对应相等，可得：

2
4 | 4 | 2 | 1 | 2 sin | cos | cos x | y | z − | + | − = | =− p | p | L | p | L θ | θ | θ | (3-14)
令 | cos

### sin

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
(3-15)

则 | 2 | 2
x | y ρ = | + pp | (3-16)

### arctan( ) y

x

p
p
ψ = | | | (3-17)

## 将式(3-15)代入式(3-14)，解得：

4 | arcsin( ) z p θψ
ρ = − | (3-18)

由上式可知：θ4 有唯一解。

由矩阵的性质还可将式(3-3)变形为：

0 | 10 | 1
1 | 5 | 5 ()⁻ TTT = | (3-19)

求解式(3-19)等号左边部分：

1 | 1
0 | 10
1 | 5
1 | 1

00
0 | 0 | 10
() | 00
0 | 0 010 0 0 1
x | x | x | x
y | y | y | y
z | z | z | z
c | s | noa p
| | noa p
s | c | noa p

θθ

θθ

−

- | | | | − = | | − | | | | | |
TT | (3-20)

求解式(3-19)等号右边部分：

| 3 | 3 | 3 | 3
| 3 | 3 | 3 | 3
1
5 | 3 | 3 | 3 | 3
0 | 0 | 0 | 1
x | x | x | x
y | y | y | y
z | z | z | z
n | o | a | p
n | o | a | p
n | o | a | p
=

T (3-21)

（4）求解θ5：由式(3-19)等号两边矩阵元素(2, 1)、(2, 2)分别对应相等，可得：

3
2 | 3 | 5 | 5 | 2 | 4 | 3 | 4 | 2 sin sin sin | cos (cos sin | cos cos sin ) z | y −= | = n | n | θθθ | θ | θθ | θ θθ − | − | (3-22)

3
2 | 3 | 5 | 5 | 2 | 4 | 3 | 4 | 2 sin sin cos | sin (cos sin | cos cos sin ) z | y −= | = o | o | θθθ | θ | θθ | θθθ + | − | (3-23)

## 联立式(3-22)与式(3-23)，可得：

5 | 5 | 2 | 3 sin | cos | sin sin z | z n | o θ | θ | θθ + | =− | (3-24)
令 | cos

### sin

z

z

nm
om

φ
φ
- =
- = | (3-25)
则 | 2 | 2 m no = | +z | z | (3-26)

### arctan( ) z

z

o
n
φ = | (3-27)

## 将式(3-25)代入式(3-24)，解得：

2 3
5
sin sin arcsin( | )
m
θθ θ | φ = − | − | (3-28)

上式中：θ2 有唯一解，但θ3 有两解，因此θ5 有两个解，且当θ3 确定后θ5 取值唯一。

（5）求解θ1：由式(3-4)等号两边矩阵元素(1, 4)、(2, 4)分别对应相等，可得：

5 | 5 | 1 | 1 | 2 cos | sin | cos sin x | y p | p | L θ | θ | θθ + | =− | (3-29)
5 | 5 | 1 | 1 | 2 sin | cos | sin sin x | y − | + | =− p | p | L θ | θ | θθ | (3-30)

## 联立式(3-29)与式(3-30)，并将式(3-15)代入，解得：

5
1
5
sin( | ) arctan( | ) sin( | )
ψθ θ
ψθ
− = | +
(3-31)

由上式可知：θ1 有两个解，但当θ5 确定后θ1 取值唯一。

（6）多解问题的处理：本文所设计的上肢外骨骼机械臂为满足运动训练要求，各关

节均须在一定范围内转动，在逆运动学求解完成后，参照各关节转动范围逐级剔除多余

解。

### 3.2 运动学仿真

采用 D-H 参数法建立的正、逆运动学求解方法一次只能进行一个特定位姿的求解，

操作复杂，直观性差。因此，本小节借助 MATLAB 强大的矩阵计算能力、图形化显示

能力与功能多元化的工具箱进行上肢外骨骼机械臂运动学仿真分析。

## Robotics Toolbox 是澳大利亚学者 Peter Corke 基于 MATLAB 平台开发的致力于工

业机器人建模，运动学、动力学仿真与轨迹规划的专业工具箱，当前最新版本为第10版。

本文采用该工具箱 10.2 版本进行上肢外骨骼机械臂建模与运动学仿真。

3.2.1 机械臂运动学模型的建立

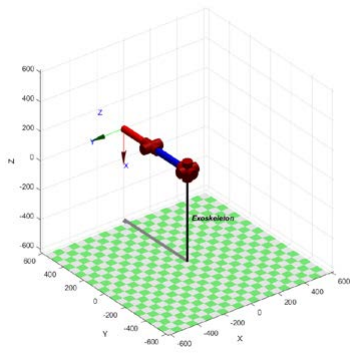
[picture p57: figure]

图 3-2 机械臂运动学模型图

（1）调用 Link 函数：在 Robotics Toolbox 中，机器人各关节被简化为杆件的形式，

调用 Link 函数可建立单个杆件模型并定义杆件参数。Link 函数调用规则如下：
L( ) Link , , , , ,CONVENTION i | da = | ([θ | ασ i | i | i | i | ] | )

其中：i 表示第 i 个杆件；θ 表示关节转角；d 表示关节偏移；a 表示杆件长度；α表

示杆件扭角；σ表示关节类型，可取 0 或非 0，0 表示旋转关节，非 0 表示移动关节；

## CONVENTION 可取‘standard’或‘modified’，‘standard’代表标准型，‘modified’代

表改进型。

（2）调用 SerialLink 函数，将建立的各杆件连接成杆组，调用规则为：

### Robot SerialLink(L,'name', NAME) =

其中，NAME 为机器人名。

（3）调用 plot 函数，绘制机械臂运动学模型图，调用规则如下：

### plot(Robot, ) θ

其中，θ 表示机械臂各关节转角向量。

最终，建立如图 3-2 所示的机械臂运动学模型。

3.2.2 正运动学仿真

在上节所建立的机械臂运动学模型的基础上，调用 fkine 函数进行正运动学仿真，

以验证正运动学理论分析结果的准确性。fkine 函数调用规则为：

### T = fkine(Robot, ) θ

其中，T 代表末端位姿矩阵，θ 代表机械臂各关节转角向量。

## 将θ = [90°,-90°,0°,180°,0°]代入 fkine 函数，可求得末端位姿矩阵 T 如下：

0 10 0
0 0 1 620
100 0
0 00 1

−
= − T

上述末端位姿矩阵 T 与式(3-4)对比可知，正运动学理论分析结果与 MATLAB 仿真

结果一致，验证了正运动学理论分析的准确性。

3.2.3 逆运动学仿真

在机械臂运动学模型与正运动学仿真的基础上，调用ikine函数进行逆运动学仿真，

ikine 函数调用规则为：

q | T | M = ikine(Robot, ,'q0', ,'mask ', ) θ

其中：q 为反解求得的各关节转角向量；T 为要反解的末端位姿矩阵；‘q0’为函数

关键字，θ 为各关节转角初始猜测值；‘mask’为函数关键字，M 为[1, 1, 1, 1, 1, 1]，默

认机器人具有 6 个自由度，当机器人自由度少于 6 个时，要将 M 中对应元素改为 0。

将正运动学仿真求得的末端位姿矩阵 T 代入 ikine 函数，可得：

- | 1.5708, -1.5708, 0, 3.1416, 0 | q =

上式所示的反解结果与正运动学仿真时输入的各关节转角向量相一致，验证了逆运

动学仿真分析的准确性。

## 第 4 章 机械臂工作空间分析与轨迹规划

机器人的工作空间是指机器人在运行时其末端执行器坐标系原点所能达到的空间

范围，是衡量机器人实际应用性能的一个重要指标。在机器人学中，轨迹是指机器人各

关节在运动过程中的位移、速度和加速度，对其进行规划，以期求得预期的任务轨迹。

进行机械臂工作空间分析与轨迹规划可进一步验证外骨骼机器人的实际可行性。

### 4.1 机械臂工作空间分析

## 4.1.1 理论基础

本文基于蒙特卡洛法利用 MATLAB 软件计算外骨骼机械臂的工作空间。蒙特卡洛

法又名统计模拟法，是指使用随机数或伪随机数解决计算问题的一种方法，将其应用于

机器人工作空间分析中可快速、简单、准确地求解出机器人的工作空间，随机计算次数

越多，求解结果越精确。

机器人的工作空间可用 W(p)表示，W(p)边界上的点所对应的机器人的位姿均为奇异

位形。机器人位于奇异位形时，机器人各关节的速度反解不存在，关节力矩趋近于无穷

大。基于蒙特卡洛法求解工作空间实质上是随机产生一系列处于机器人各关节运动范围

内的关节运动角度，然后将这些随机关节运动角度代入基于 D-H 参数法建立的机器人

正运动学方程，得到一系列机器人末端坐标系原点的空间位置，这些空间位置的集合便

是机器人的工作空间。

机器人第 i 个关节的随机转动角度可由式(5-1)求得。

min | max | min ( | ) | ( ,1) i | i | i | i θθ | θ | θ = | + | − | × rand N | (4-1)
上式中， max θi | 表示机器人第 i 个关节转动范围的最大值， min θi | 表示机器人第 i 个关

节转动范围的最小值，rand N( ,1)为生成一系列位于(0, 1)之间的伪随机数。

## 4.1.2 仿真分析

在第 3 章所完成的机械臂正运动学仿真分析的基础上，利用 MATLAB 编程求解机

械臂的工作空间，取随机计算次数 N = 30000，仿真结果如图 4-1 所示。

## 由图 4-1 可看出：机械臂的工作空间为-500mm ≤ x ≤ 250mm，-300mm ≤ y ≤ 600mm， -600mm ≤ z ≤ 200mm。

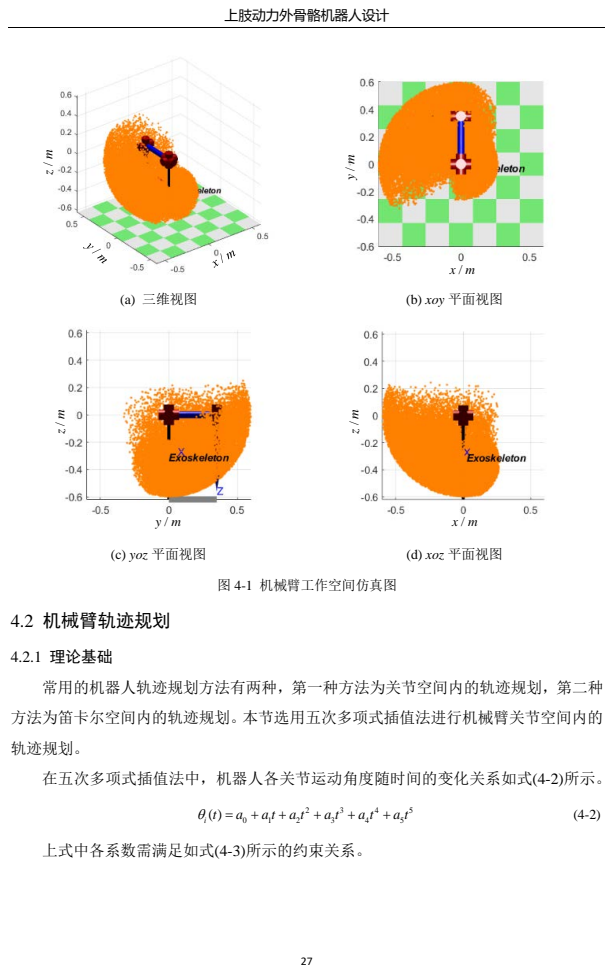
[picture p58: page 28]
(a) 三维视图; (b) xoy 平面视图; (c) yoz 平面视图; (d) xoz 平面视图; 图 4-1 机械臂工作空间仿真图; 4.2 机械臂轨迹规划; 4.2.1 理论基础; 方法为笛卡尔空间内的轨迹规划。本节选用五次多项式插值法进行机械臂关节空间内的; 上式中各系数需满足如式(4-3)所示的约束关系。

常用的机器人轨迹规划方法有两种，第一种方法为关节空间内的轨迹规划，第二种

轨迹规划。
在五次多项式插值法中，机器人各关节运动角度随时间的变化关系如式(4-2)所示。

0 | 0
2 | 3 | 4 | 5
1 | 0 | 1 | 2 | 3 | 4 | 5
0 | 1
2 | 3 | 4
1 | 1 | 2 | 3 | 4 | 5
0 | 2
2 | 3
1 | 2 | 3 | 4 | 5
2 | 3 | 4 | 5
2
2 | 6 | 12 | 20

a
a at at at at at
a
a | at at | at | at
a
a | at | at | at

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
=+ + | + | + | +
- =
=+ | + | + | +
- =
- = | + | + | +

(4-3)

上式中，θ0 为初始关节角度，θ1 为终止关节角度，t 为运动时间。

式(4-3)含有六个未知数和六个方程，可联立解得：

0 | 0
1 | 0

0
2

2
1 | 0 | 1 | 0 | 0 | 1
3 | 3

2
0 | 1 | 1 | 0 | 0 | 1
4 | 4

2
1 | 0 | 1 | 0 | 0 | 1
5 | 5

2
20 | 20 | (8 12 ) (3 | )
2
30 | 30 | (14 16 ) (3 | 2 )
2
12 12 | (6 | 6 ) ( | )
2

a
a

a

t | t
a
t
t | t
a
t
t | t
a
t

θ
θ
θ
θ | θ | θ | θ | θθ
θ | θ | θ | θ | θθ
θ | θ | θ θ | θθ

•

••

- | • | •• | ••
- | • | •• | ••
- | • | •• | ••
- =
- =
- =
- | − | − | + | − | − =
- | − | + | + | + | − =
− | − | + | −− =

(4-4)

将式(4-4)代入式(4-2)便可得到机械臂轨迹规划所需的五次多项式插值函数。

## 4.2.2 仿真分析

本小节将承接上文内容，利用 MATLAB Robotics Toolbox 进行外骨骼机械臂轨迹规

划仿真。

首先，设定外骨骼机械臂在进行轨迹规划时各关节初始角度与终止角度分别如式(4-

## 5)、式(4-6)所示。

POS1 = | °− ° ° | ° ° [90 , 90 ,0 ,180 ,0 ] | (4-5)
POS2 = | °− °− ° | ° ° [180 , 45 , 45 ,144 ,30 ] | (4-6)

然后，在第 3 章所建立的正运动学仿真分析模型的基础上，调用 jtraj 函数进行机

械臂轨迹规划仿真。jtraj 函数调用格式如下：

[q qd qdd | POS POS , , | jtraj | , | , ] = | ( | 1 | 2 T )

其中，q 为函数返回的关节角位移矩阵，qd 为函数返回的关节角速度矩阵，qdd 为

函数返回的关节角加速度矩阵，T 为给定的时间向量的长度。

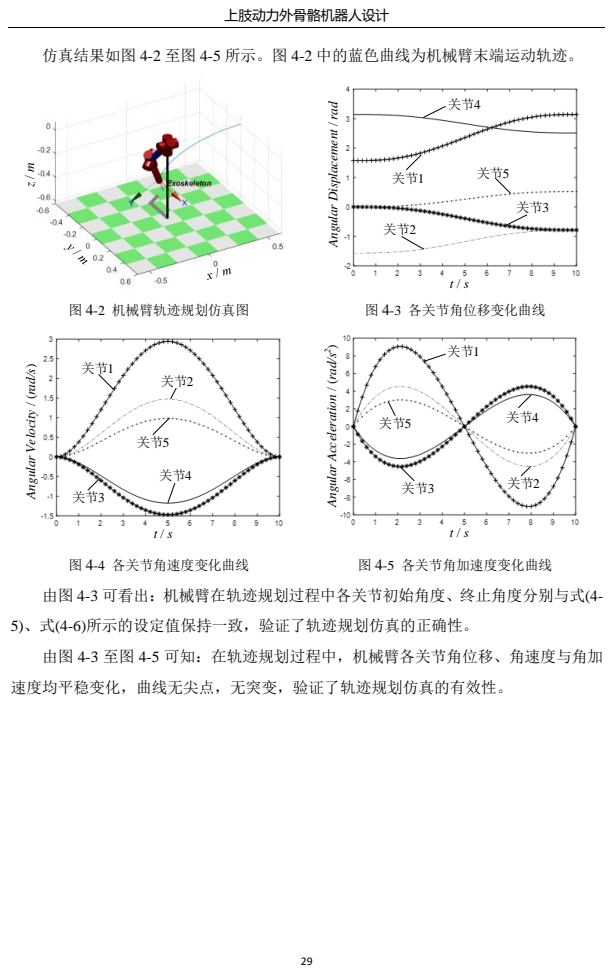
[picture p59: page 30]
图 4-2 机械臂轨迹规划仿真图; 图 4-3 各关节角位移变化曲线; 图 4-4 各关节角速度变化曲线; 图 4-5 各关节角加速度变化曲线; 5)、式(4-6)所示的设定值保持一致，验证了轨迹规划仿真的正确性。

仿真结果如图 4-2 至图 4-5 所示。图 4-2 中的蓝色曲线为机械臂末端运动轨迹。

Angular Displacement / rad

Angular Acceleration / (rad/s

Angular Velocity / (rad/s)

由图 4-3 可看出：机械臂在轨迹规划过程中各关节初始角度、终止角度分别与式(4-

由图 4-3 至图 4-5 可知：在轨迹规划过程中，机械臂各关节角位移、角速度与角加

速度均平稳变化，曲线无尖点，无突变，验证了轨迹规划仿真的有效性。

## 第 5 章 机械臂动力学分析与仿真

进行机器人动力学分析的目的是找出机器人各关节驱动力矩与末端运动参数（位移、

速度与加速度）之间的关系，为机器人控制系统的研究奠定基础，为机器人驱动系统的

选择提供参考依据。动力学分析问题可分为两类，一类是已知机器人的驱动力矩求解各

关节运动参数，称为动力学正问题；另一类与前者相反，称为动力学逆问题。本章主要

以上文第 3 章、第 4 章研究结果为基础，分析外骨骼机械臂的动力学逆问题。

### 5.1 动力学理论分析

目前，常用的机器人动力学分析方法有拉格朗日方程法、牛顿-欧拉方程法、旋转代

数法与凯恩方程法[28]。本章选用拉格朗日方程法进行上肢外骨骼机械臂的动力学分析。

5.1.1 机械臂的动能

机械臂第 i 个连杆上任一质点的速度表达式如式(5-1)所示。其中，Ti 为该连杆上的

局部坐标系相对于基坐标系的齐次变换矩阵， j q 为机械臂第 j 个关节的广义坐标， j q

•
为

机械臂第 j 个关节的广义速度，i
r 为该点在局部坐标系中的位置矢量。

1

i
i i
j
j | j
v | q
q
| •

=

- | ∂ = | ∂ |
∑ T
r | (5-1)

该质点的质量为 dm，则其动能为：
( ) 11

1
2
i | i | T
i | i i | iT
i | jk
j | k | j | k
dK | Trace | dm | q q
q | q
| | | ••
= | =
- | ∂ | ∂ = | | ⋅ | ⋅ ∂ | ∂ |
∑∑ T | T
r | r | (5-2)

式中，Trace 表示矩阵的迹，其值为矩阵主对角元素之和。

对式(5-2)积分可得机械臂第 i 个连杆的动能，如式(5-3)所示。

11

1
2
i | i | T
| | | i | i
i | i | i | jk
i | j | k | j | k
K | dK | Trace | q q
q | q
| | | ••
= | =
- | ∂ | ∂ = | = | | ∂ | ∂ | ∫ | ∑∑

连杆

T | T I | (5-3)

上式中，Ii 为伪惯量矩阵，其表达式如式(5-4)所示，Iixx 等表示连杆 i 的惯性积。

2

2

2

i iT
i
i
ixx | iyy | izz
| ixy | ixz | i i
ixx | iyy | izz
ixy | | iyz | i i
ixx | iyy | izz
ixz | iyz | | i i
i i | i i | ii | i

dm

I | I | I
| I | I | mx
I | I | I
I | | I | my
I | I | I
I | I | | mz
mx | my | mz | m
= | ⋅ | ⋅
- | + | +
- −
− +
=
+ −

∫

连杆

I rr

(5-4)

机械臂所有连杆的动能之和为机械臂的总动能 Kr，其表达式如式(5-5)所示。

1 | 1 | 11

1
2
n | n | i | i | T
| | | | i | i
r | i | i | jk
i | i | j | k | j | k
K | K | Trace | q q
q | q
| | | ••
= | = | = | =
- | ∂ | ∂ = | = | | ∂ | ∂ | ∑ | ∑ | ∑∑ T | T I | (5-5)

机械臂系统中除各连杆具有动能外，传动装置的动能 Kai 也不可忽略。连杆 i 的传

动装置的动能的表达式为：
1 | 2
2 K | Iq ai | ai i

•
= | (5-6)

上式中，Iai 表示传动装置的等效转动惯量。

机械臂各连杆传动装置的总动能如式(5-7)所示。

2

1

1
2

n
a | ai i
i

K Iq •

=

= ∑ | (5-7)

式(5-5)与式(5-7)相加可得机械臂系统的总动能：

2

1 | 11 | 1
1 | 1
2 | 2
r | a
n | i | i | T | n
i | i
i | j k | ai i
i | j | k | i j | k

KK K

Trace | q q | I q
q | q
•• | •
= | = | = | =
= | +
- | ∂ | ∂ = | | +
∂ | ∂ | ∑ | ∑∑ | ∑ T | T I | (5-8)

5.1.2 机械臂的位能

机械臂第 i 个连杆上 i
r 位置处的质量为 dm 的质点的位能如式(5-9)所示。
T | i
i | i dP | dm = −gT r | (5-9)
上式中， | , , ,1 T
x | y | z = | ggg | g | ，g 为重力加速度。

式(5-9)积分可得机械臂第 i 个连杆的位能：

T | i | T | i
i | i | i | i | ii
i | i
P | dP = | = − | = dm m− ∫ | ∫
连杆 | 连杆
gT | r | gT r | (5-10)

上式中，mi 为机械臂第 i 个连杆的质量，i
ir 第 i 个连杆相对于其前端关节坐标系的

重心位置。

由于机械臂传动装置的质量很小，其位能可忽略不计，因此机械臂系统的总位能约

等于机械臂各连杆的位能之和，其表达式如式(5-11)所示。

( | ) 1 | 1 | 1
n | n | n | T | i
i | ai | i | i | i i
i | i | i
P | PP | P | m = | = | =
= | + | ≈ | =− ∑ | ∑ | ∑ gT r | (5-11)

5.1.3 机械臂的拉格朗日方程

根据拉格朗日方程的定义，机械系统的拉格朗日函数 L 为其动能与势能之差：
LKP = − | (5-12)

将式(5-8)、式(5-11)代入上式，可得：

2

1 | 11 | 1 | 1
1 | 1
2 | 2
n | i | i | T | n | n
i | i | T | i
i | j k | ai i | i | i i
i | j | k | i | i j | k
L | Trace | q q | I q | m
q | q
•• | •
= | = | = | = | =
- | ∂ | ∂ = | | | + | +
∂ | ∂ | ∑∑∑ | ∑ | ∑ T | T I | gT r | (5-13)

由式(5-12)所示的拉格朗日方程可推导出机械系统的动力学方程，如式(5-14)所示。

其中， i τ 为机械臂第 i 个关节处的广义力， i q 为机械臂第 i 个关节的广义坐标， i q

•
为机

械臂第 i 个关节的广义速度。

i
i i
dL | L
dt | q q
τ | •
∂ | ∂ = | − ∂ ∂
(5-14)

将式(5-11)代入，可得：

1
2
1 | 1
j | T n | j | j
i | j | k | ai i
jik | k | i
j | j | T n | n j | j | T | j j
j | km | i | j
jik m | k | m | i | j i | i
Trace | q I q
q | q
Trace | q q | m
qq | q | q
τ | •• | ••
= | =

••

= | = | = | =
- | ∂ | ∂ = | | +
∂ | ∂ |
- | ∂ | ∂ | ∂
+ | − |
∂∂ | ∂ | ∂ |

∑∑

∑∑∑ | ∑

T T
I
T | T | T
I | g | r

(5-15)

可将式(5-15)化简为：

1 | 11
n | nn
i | ij j | ai i | ijk j k | i
j | j | k
τ | Dq I q | D qq D •• | •• | • •
= | = | =
= | + | + | + ∑ | ∑∑ | (5-16)

式中：

max( , )
2

max( , , )

T n | p | p
ij | p
p | ij | j | i
T n | p | p
ijk | p
p | i jk | j | k | i
n | T | p p
i | p | p
pi | i
D | Trace
q | q
D | Trace
qq | q
D | m
q

=

=

=

- | ∂ | ∂ = | |
∂ | ∂ |
- | ∂ | ∂ = | |
∂∂ | ∂ |
∂ = − | ∂

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
## 5.2 ADAMS 动力学仿真

## ADAMS 全称为 Automatic Dynamic Analysis of Mechanical Systems (机械系统动力

学自动分析)，是美国机械动力公司开发的一款虚拟样机分析软件。本文利用其进行外骨

骼机械臂动力学仿真。

5.2.1 仿真前的准备工作

利用 ADAMS 进行动力学仿真前，需完成以下准备工作：

（1）环境设置：设置“单位”为“MMKS”；设置重力方向为“-Z”方向，大小为

## 9806.65mm/s²

。

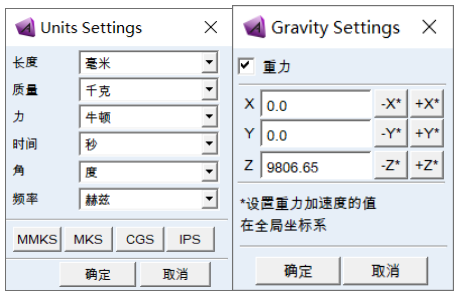
[picture p60: figure]

图 5-1 ADAMS 工作环境设置

（2）导入机械臂三维模型：SOLIDWORKS 软件所建立的模型的默认文件格式

为.SLDPRT 或.SLDASM，而 ADAMS 软件不能识别这两种文件类型。若要利用

SOLIDWORKS 软件所建立的模型在 ADAMS 中进行动力学仿真，需完成以下操作：首

先，在 SOLIDWORKS 软件中将外骨骼模型导出为 parasolid 格式的文件，然后将其导入

## ADAMS 中。

（3）定义构件材料属性：为使仿真结果反映真实实验效果，在仿真前需要设置模型

各构件的材料属性，软件在仿真过程中将自动计算出模型的质量、质心坐标等物理参数。

为满足外骨骼设计轻量化要求，将机械臂主体构件材料定义为“Aluminum”。

（4）修改构件名称与颜色：在仿真前修改各构件的名称、颜色等特征，以便清晰地

区分机械臂各构件，使模型美观化，仿真结果直观化。

（5）添加约束：上肢外骨骼机械臂具有 5 个转动自由度，须在 ADAMS 模型中添

加五个转动副以满足机械臂的运动要求。此外，为使外骨骼在仿真空间中具有确定的位

置，保证仿真准确稳定，应添加 1 个固定副。设置外骨骼机械臂 ADAMS 仿真模型各构

件间的运动约束关系如表 5-1 所示。

表 5-1 机械臂各构件间的运动约束关系

构件 1 | 构件 2 | 运动约束关系 | 运动副名称
大地(ground) | 小肩板 | 固定副 | JOINT_Fixed
小肩板 | 大肩板 | 转动副 | JOINT_1
大肩板 | 上臂 | 转动副 | JOINT_2
上臂 | 上臂环 | 转动副 | JOINT_3
上臂 | 前臂 | 转动副 | JOINT_4
前臂 | 前臂环 | 转动副 | JOINT_5

完成上述准备工作后得到的外骨骼机械臂 ADAMS 仿真模型如图 5-2 所示。

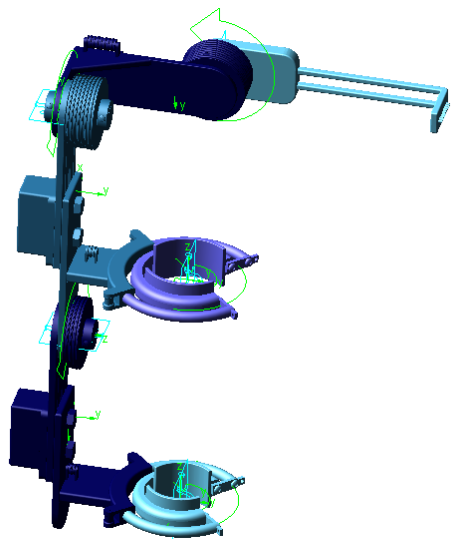
[picture p61: figure]

图 5-2 ADAMS 仿真模型

5.2.2 仿真过程与结果

本小节主要介绍上肢外骨骼机械臂在仅受自身重力情况下的动力学仿真，取第 4 章

轨迹规划时机械臂各关节的运动参数为仿真条件，求取机械臂各关节的驱动力矩变化曲

线。仿真过程主要分为以下三步：

（1）导入运动轨迹：首先，从 MATLAB 中导出机械臂轨迹规划时各关节的角位移

变化数据，将各关节的角位移变化数据分开处理成以时间为变量的数据格式，并分别保

存为.txt 文件格式。在进行轨迹规划时各关节角度有初始值，不为 0，而在 ADAMS 中

的驱动初始角度为 0，因此需要对数据进行处理。然后，在 ADAMS 界面中点击“文件”

下拉菜单中的“导入”选项，将“文件类型”设置为“实验数据(*.*)”，选择“创建样条

线”选项，读取保存的.txt 文件，将各关节运动轨迹分别导入到 ADAMS 软件中。

## （2）添加驱动函数：ADAMS 中的 Spline 函数提供了 CUBSPL、CURVE 与 AKISPL

三种插值方法，本文选取 CUBSPL 函数作为机械臂各关节的驱动函数，调用格式为：

## CUBSPL( time , 0 , SPLINE_NAME , 0 )，其中，JOINT_1 至 JOINT_5 的样条轨迹依次为 SPLINE_1 至 SPLINE_5。

（3）仿真分析与后处理：完成上述工作后，点击“仿真”选项卡中的“运行交互仿

真”选项，进行机械臂动力学仿真。仿真运行结束后在 ADAMS 后处理模块导出机械臂

各关节驱动力矩变化曲线，如图 5-3 所示。

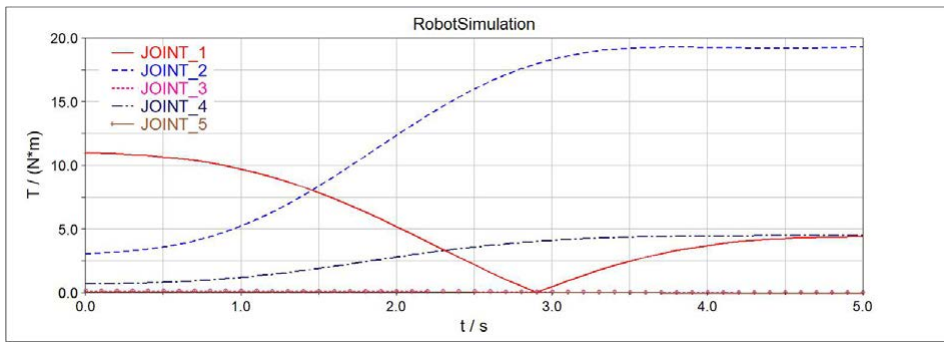
[picture p62: figure]

图 5-3 机械臂各关节驱动力矩曲线

由上图可知：机械臂各关节驱动力矩变化平稳，最大驱动力矩约为 19Nm，最小驱

## 动力矩为 0。JOINT_1 驱动力矩先从 11Nm 减小为 0，后增大至 4.5Nm，JOINT_2 与

JOINT_4 的驱动力矩均逐渐增大后保持平稳。在仿真过程中机械臂各构件均仅受自身重

力，JOINT_3 与 JOINT_5 均无负载，故关节驱动力矩始终为零。

## 第 6 章 上肢外骨骼机器人控制策略设计

本文设计的上肢动力外骨骼康复机器人的主要应用对象为人体上肢，主要应用场景

为助力穿戴者上肢的自由运动与负重训练。由第一章分析可知，人体上肢肩、肘关节共

有 5 个自由度，因此可以进行复杂的运动。本章将以上肢运动中基本的肘关节前屈、后

伸为例，介绍机器人系统在负重情况下进行搬运运动的控制策略。其他更加复杂的运动

可以分解为一系列在其他关节或其他方向上的类似的运动，采用类似的控制策略。

### 6.1 有限状态机控制策略

在上肢动力外骨骼康复机器人进行肘关节的前屈、后伸运动过程中，我们定义小臂

和人体冠状面的夹角为肘关节角度 θ，如图 6-1 所示，前屈为其正方向，前屈时肘关节

角度增加，后伸时肘关节角度减小。

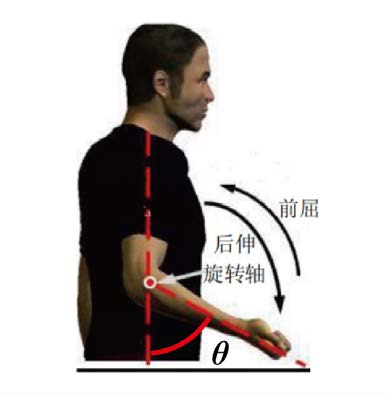
[picture p63: figure]

图 6-1 运动示意图

我们设计了一种有限状态机控制策略对外骨骼的搬运动作进行控制，如图 6-2 所示。

工作状态共包括三种状态：提升状态，下降状态和支撑状态。提升状态，即进行肘关节

的前屈运动，此时肘关节电机为主动模式，采用位置控制；下降状态，即进行肘关节的

后伸运动，此时肘关节电机为阻尼模式，进行阻抗控制；支撑状态，即肘关节维持不动

的状态，此时肘关节电机也为阻尼状态，进行刚度很高的阻抗控制。

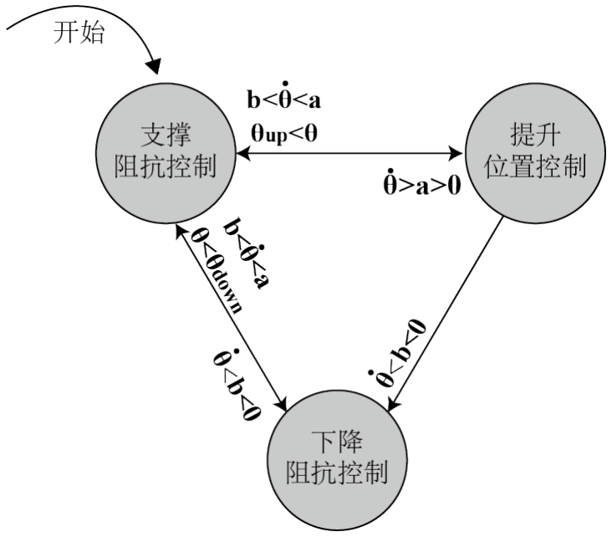
[picture p64: figure]

图 6-2 三种控制状态的相互转换

有限状态机的切换方法如图 6-2 所示，上肢动力外骨骼康复机器人的初始状态为某 一角度下的支撑状态。当θθ̇ > aa > 0时，从支撑状态进入提升状态，电机进入主动模式，

在位置控制下转动至指定位置。此时aa > θθ̇ > bb，即角速度在 0 附近波动，且θθ > θθuuuu，

从提升状态进入支撑状态，通过阻抗控制提供大阻尼力矩，维持上肢动力外骨骼康复机

# 器人的稳定；随后当0 > bb > θθ̇

时，从支撑状态进入下降状态时，电机进入阻尼模式，上

肢动力外骨骼康复机器人在负载与自重的共同作用下做后伸运动，并在阻尼控制提供的

阻抗力矩作用下缓慢停止。下降状态的阻抗控制刚度小于支撑状态的刚度。当aa > θθ̇ >

bb，且θθdddddddd > θθ时，从下降状态进入支撑状态。若提升时，还没有上升到特定位置便开

始下降，则直接从提升状态切换到下降状态。

### 6.2 阻抗控制方法

由第一节的分析可知，上肢动力外骨骼康复机器人在下降状态与支撑状态下，肘关

节电机都工作在阻尼模式，提供阻抗力矩。阻抗控制系统采用两级的闭环控制，其示意

图如图 6-3 所示。

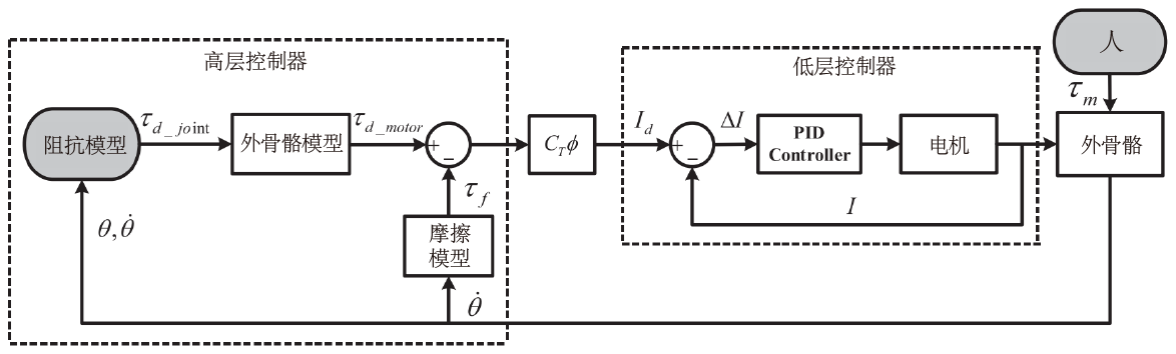
[picture p65: figure]

图 6-3 阻抗控制流程图

前一级的高级控制器根据外骨骼传感反馈获得的角度和速度信息，经过阻抗模型的

计算得到关节力矩；关节力矩经过外骨骼模型的解算获得肘关节电机力矩；除此以外，

还要考虑由传感反馈获得的速度信息经摩擦模型计算得到的摩擦力矩，得到最终的肘关

节电机力矩控制值。阻抗模型公式如下：

# τdjjjjj = kk1θθ − θee + kk2θθ − θee

2

# + bbθθ̇ (6-1)

其中kk1、kk2、bb为刚度系数，θθ为电机当前位置，θθeeee为下降开始前支撑状态的平衡位

置。在下降状态下，θθ越大，下降越多；θθ̇

越大，下降速度越快，阻抗力矩越大，起到阻

止下降的效果。在支撑状态下，各刚度系数远大于下降状态下的控制系数，阻抗力矩也

大得多。

外骨骼模型为通过传动机构传动比将关节力矩转换为电机力矩。

τdm m = Gτdjjjjj | (6-2)

GG为传动比。摩擦模型如下方公式所示，得到摩擦力矩。

# ττff = bbffθθ˙ + ccff ⋅ sgnθθ˙ (6-3)

其中，bf 是粘性阻尼系数，cf 表示库仑摩擦力。bf 和 cf 是根据离线数据进行线

性拟合估算的。

后一级的低级控制器则是电机产生阻抗力矩的执行机构。电机阻尼模式的原理为，

在阻尼模式下，电机不接电源，当上肢运动带动电机转动时，在磁场作用下，转动的电

机可以切割磁感线产生感应电动势EEaa：

# Ea = CE∅n (6-4)

其中CCEE为考虑了整流电路在内的电动势常数，∅为磁场强度，nn为电机转速。

如果电机电枢绕组接通，就会在感应电动势作用下产生感应电流IIaa：

# Ia = Ea

RRaa
（6-5）
其中RRaa为电机电枢绕组的电阻值。在磁场作用下，感应电流会产生阻尼力矩ττbb：

# τb = CT∅Ia = CTCE∅2

RRaa

# nn = kkdd

RRaa

nn （6-6）

其中CCTT为电机的力矩常数，kkdd = CCTTCCEE∅2是等效的比例系数，在本文中为常数。由

此我们可知，通过对电机电枢绕组的电阻值RRaa进行控制，就可以控制电机电枢中的感

应电流，从而对电机进行阻尼控制。通过对电机电枢中的可控电力电子器件进行控

制，令电机电枢以一定频率接通和断开，就可以起到控制电机电枢电阻值RRaa的效果。

在上肢动力外骨骼康复机器人系统中，通过高级控制器给出的电机力矩控制值，

计算得出电机电枢电流的控制值，经过电机电枢电流负反馈的 PID 控制，作用于电机

中的电力电子器件后，就完成了低级控制器对电机阻尼的控制。

除了上述的两级闭环控制系统，还要考虑人体对外骨骼作用的力矩ττmm，通过力矩传

感器测量。

### 6.3 位置控制方法

由第一节的分析可知，上肢动力外骨骼康复机器人在上升状态下采用位置控制工作

在主动模式。位置控制采用带有负反馈的 PID 控制，其过程与阻抗控制类似。外骨骼上

的传感反馈获得实际位置的反馈，预期位置与其比较后得到误差经 PID 控制计算得到末

端关节电机的控制力矩，而关节电机的力矩控制由控制电压实现，最终作用于外骨骼，

实现上升状态下的位置控制。

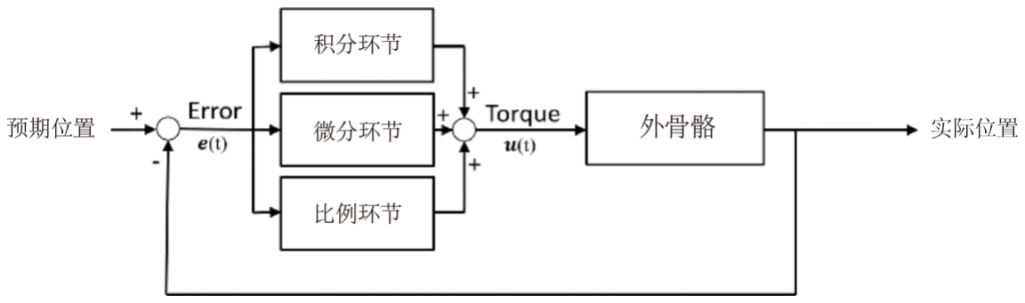
[picture p66: figure]

图 6-4 位置控制流程图

先进机器人控制课程报告——小组成员及分工

成员 | 主要分工
徐明 | 内容规划，机械结构设计
孟凡旭 | 资料汇总，运动学分析与仿真
许诺 | 工作空间分析与轨迹规划
王润 | 动力学分析与仿真
朱文铎 | 控制策略设计
