lurejewel/-/1. 机械结构/双足机器人_下肢_线图.png

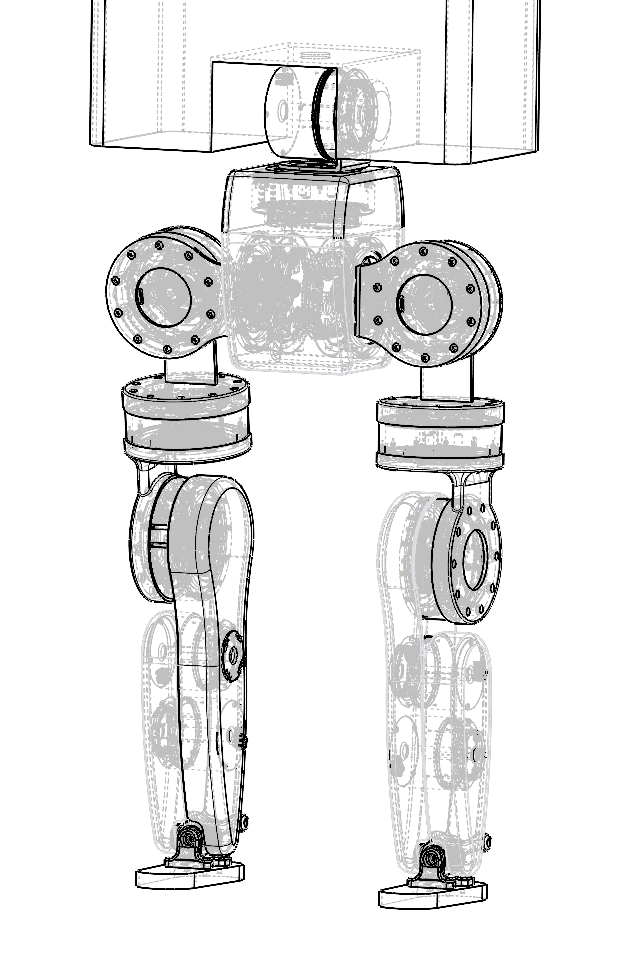
1. 机械结构/双足机器人_下肢_线图.png
