lurejewel/-/4. DH参数分析/DH参数.png

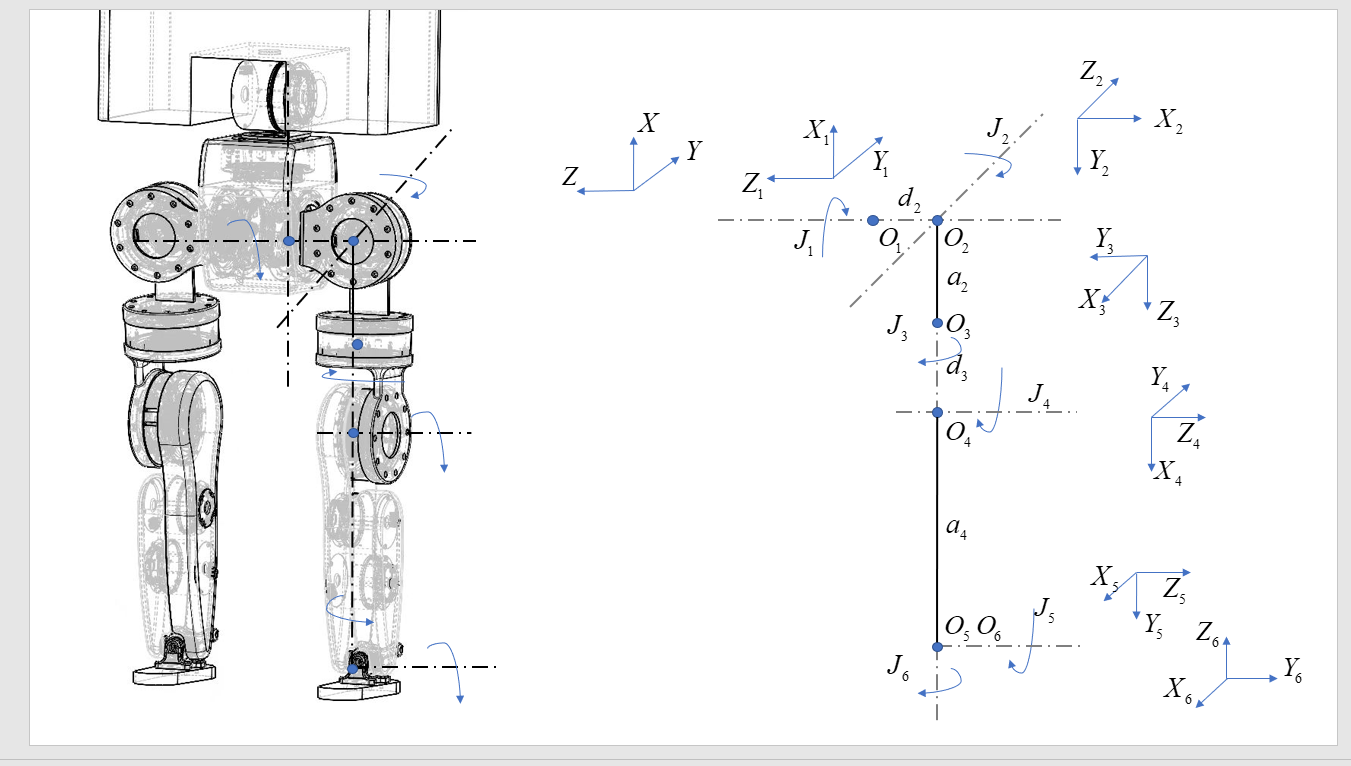
4. DH参数分析/DH参数.png
