lurejewel/-/1. 机械结构/材料（包括电机、传感器等组件）清单，请勿外传.png

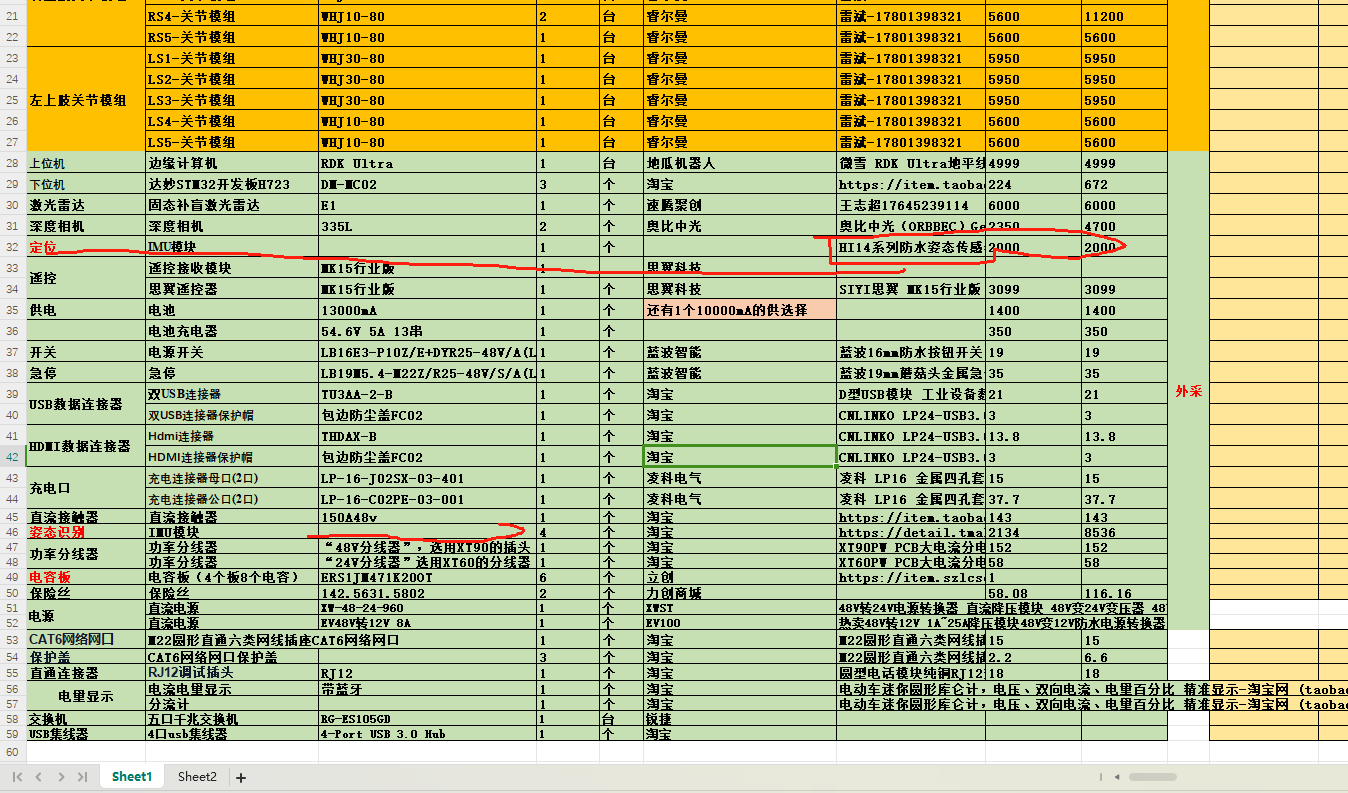
1. 机械结构/材料（包括电机、传感器等组件）清单，请勿外传.png
