lurejewel/-/1. 机械结构/先进机器人控制大模型/大合体.SLDASM

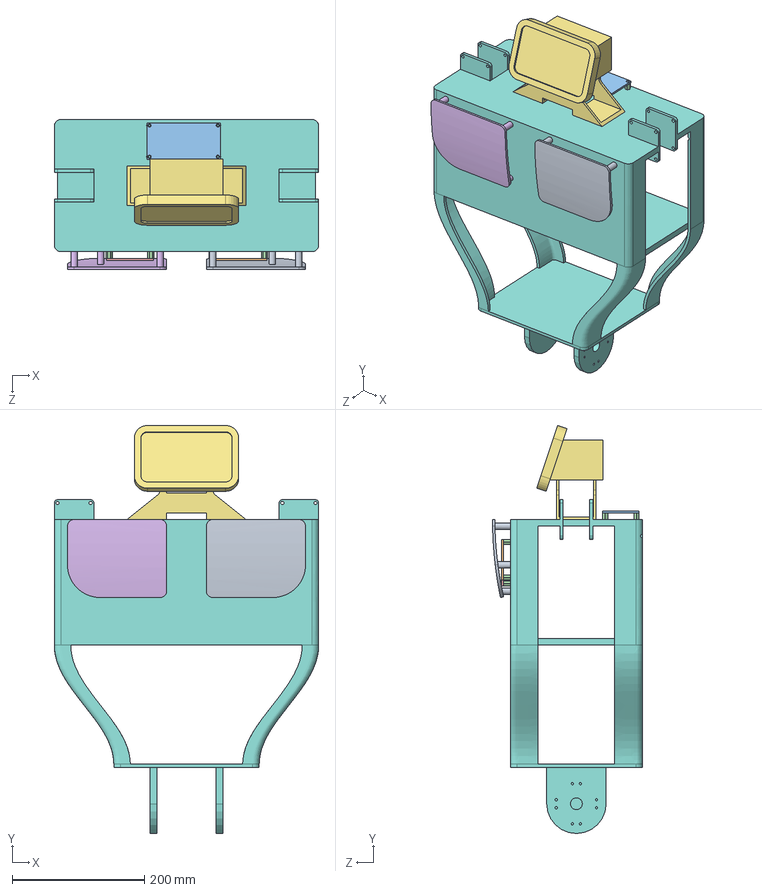
[picture p70: CAD file, 2024-12-26]
1. 机械结构/先进机器人控制大模型/大合体.SLDASM
400.0 x 617.2 x 226.9 mm
机器人也有大胸脯
你想看什么表情我都有
左大胸
板子1号
铜柱 x 12
板子3号
板子2号
镜向左大胸
