lurejewel/-/1. 机械结构/先进机器人控制大模型/左大胸.SLDPRT

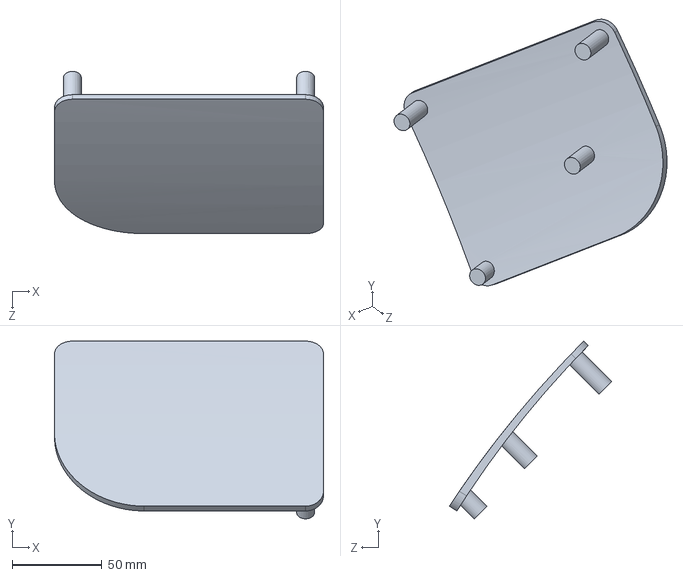
[picture p71: CAD file, 2024-12-26]
1. 机械结构/先进机器人控制大模型/左大胸.SLDPRT
150.0 x 99.1 x 90.5 mm
