lurejewel/-/2. OpenSim逆动力学仿真/assets/HAT.STL

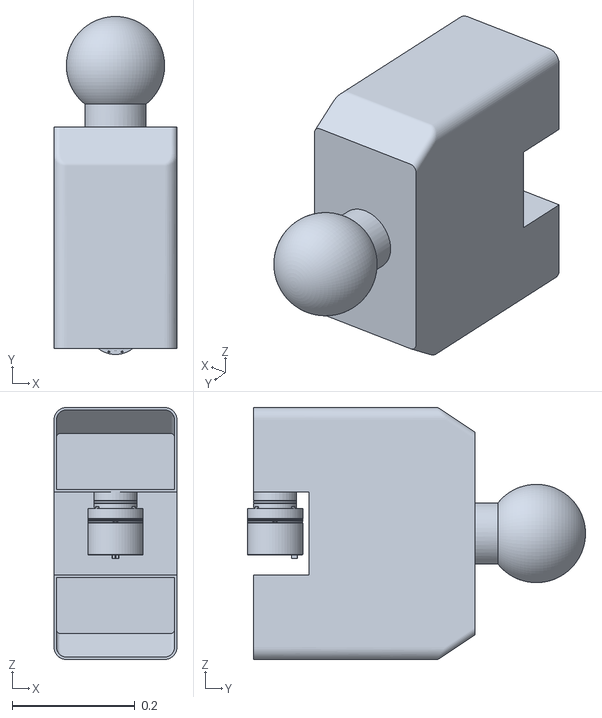
[picture p72: CAD file, 2024-12-19]
2. OpenSim逆动力学仿真/assets/HAT.STL
0.2 x 0.55 x 0.41
