lurejewel/-/3. ANSYS仿真/63右腿左外壳.STEP

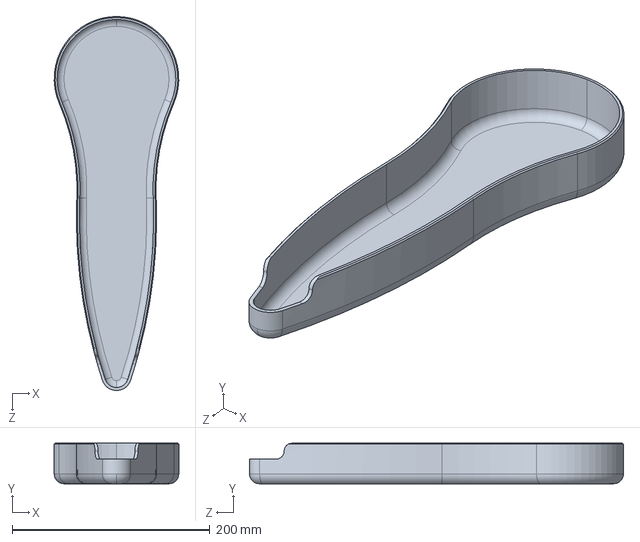
[picture p73: CAD file, 2024-12-19]
3. ANSYS仿真/63右腿左外壳.STEP
125.9 x 41.0 x 378.0 mm
