lurejewel/-/1. 机械结构/先进机器人控制大模型/板子3号.SLDPRT

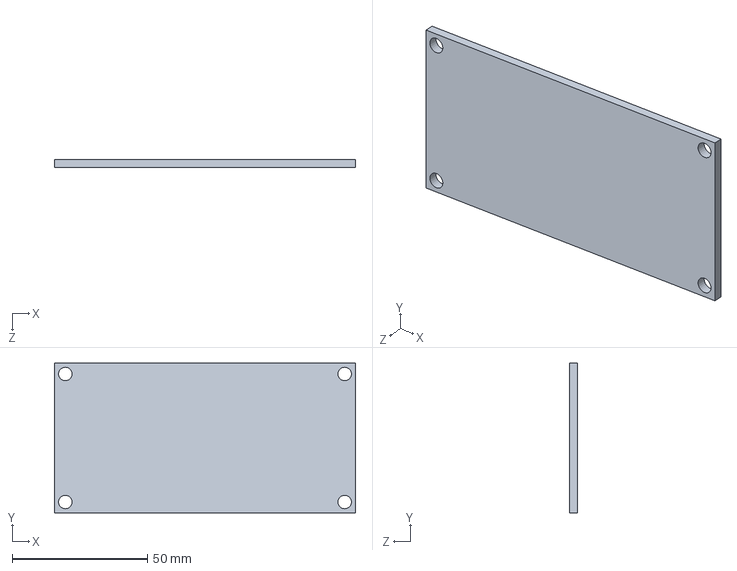
[picture p74: CAD file, 2024-12-26]
1. 机械结构/先进机器人控制大模型/板子3号.SLDPRT
111.4 x 55.4 x 3.00 mm
