lurejewel/-/2. OpenSim逆动力学仿真/assets/Shank-l.STL

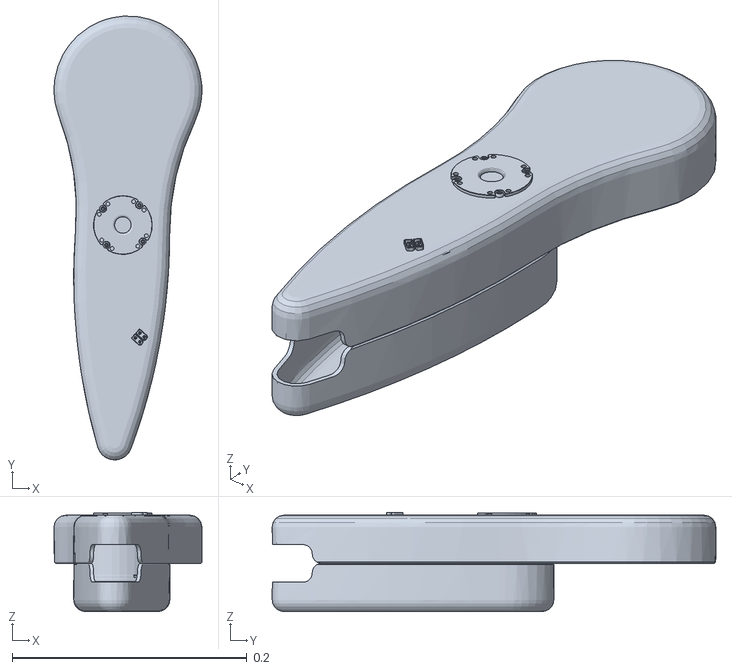
[picture p75: CAD file, 2024-12-19]
2. OpenSim逆动力学仿真/assets/Shank-l.STL
0.126 x 0.378 x 0.0843
