lurejewel/-/3. ANSYS仿真/63LBBBBearing6901_配置A.STEP

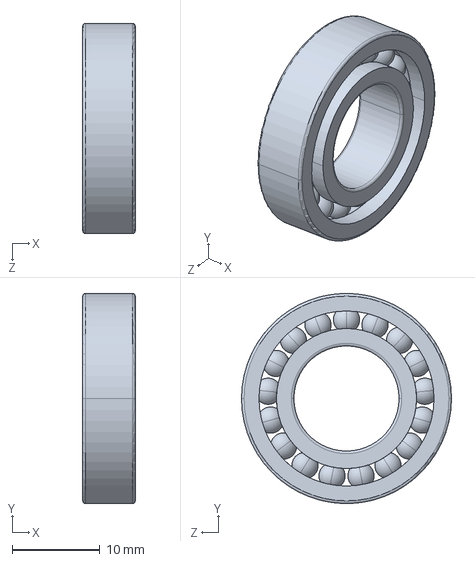
[picture p76: CAD file, 2024-12-19]
3. ANSYS仿真/63LBBBBearing6901_配置A.STEP
6.00 x 24.0 x 24.0 mm
