lurejewel/-/1. 机械结构/先进机器人控制大模型/你想看什么表情我都有.SLDPRT

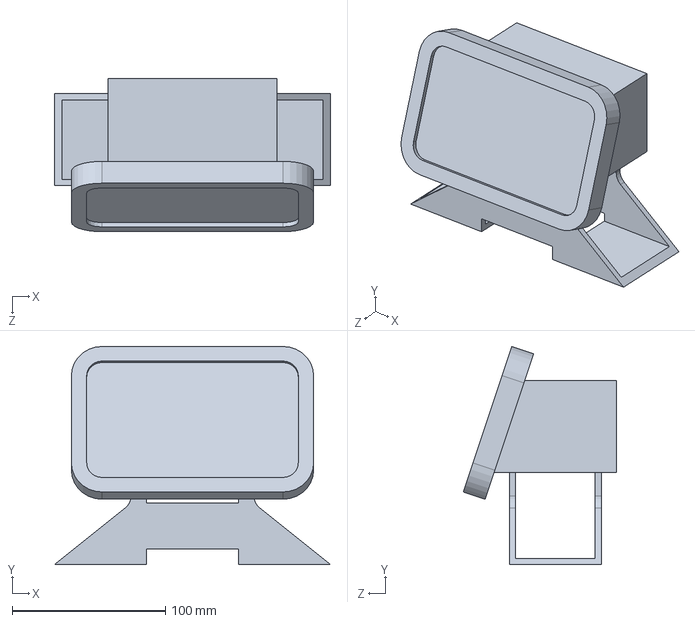
[picture p77: CAD file, 2024-12-26]
1. 机械结构/先进机器人控制大模型/你想看什么表情我都有.SLDPRT
180.0 x 142.2 x 100.0 mm
