lurejewel/-/1. 机械结构/先进机器人控制大模型/机器人也有大胸脯.SLDPRT

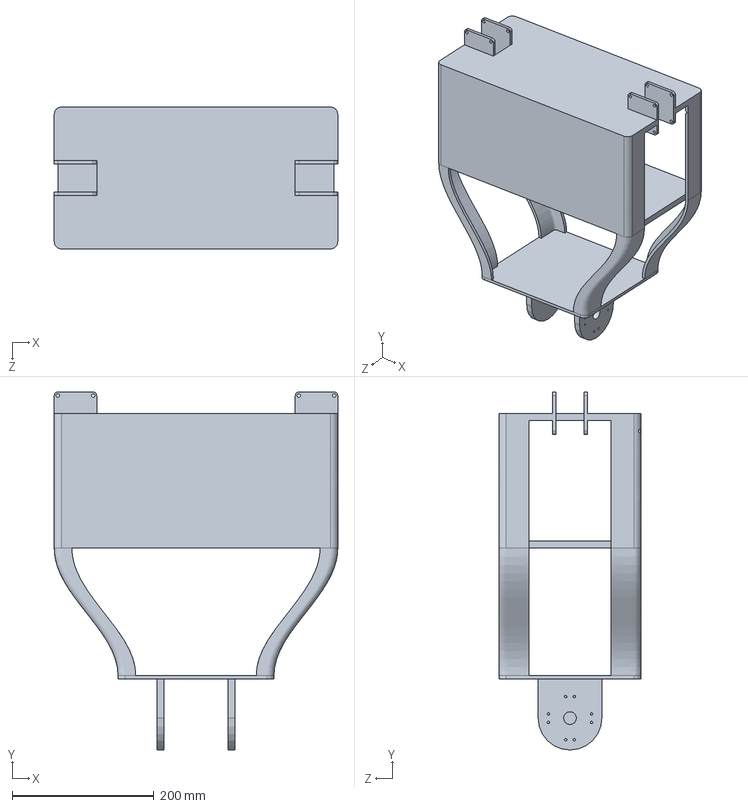
[picture p79: CAD file, 2024-12-26]
1. 机械结构/先进机器人控制大模型/机器人也有大胸脯.SLDPRT
400.0 x 505.0 x 200.0 mm
