lurejewel/-/2. OpenSim逆动力学仿真/assets/Pelvis-thigh-r.STL

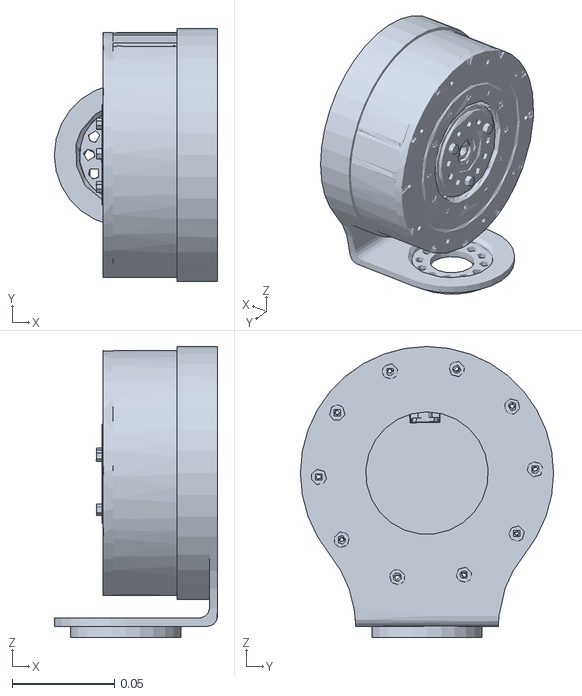
[picture p80: CAD file, 2024-12-19]
2. OpenSim逆动力学仿真/assets/Pelvis-thigh-r.STL
0.08 x 0.124 x 0.142
