lurejewel/-/1. 机械结构/先进机器人控制大模型/板子2号.SLDPRT

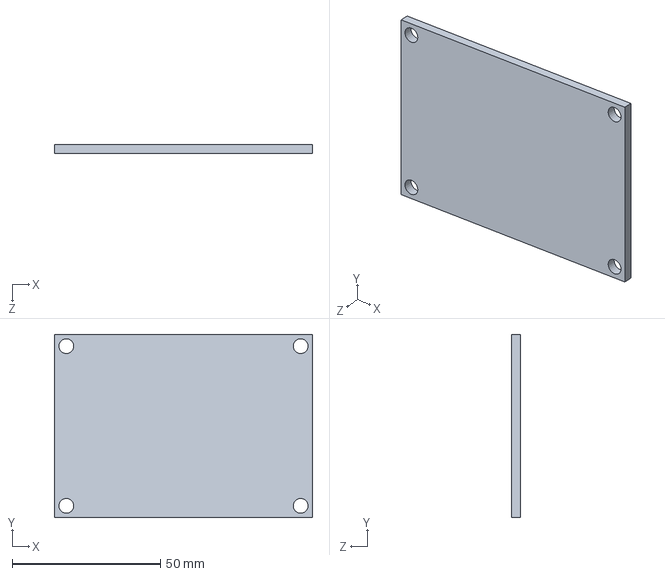
[picture p81: CAD file, 2024-12-26]
1. 机械结构/先进机器人控制大模型/板子2号.SLDPRT
87.1 x 61.9 x 3.00 mm
