lurejewel/-/2. OpenSim逆动力学仿真/assets/Thigh-1-r.STL

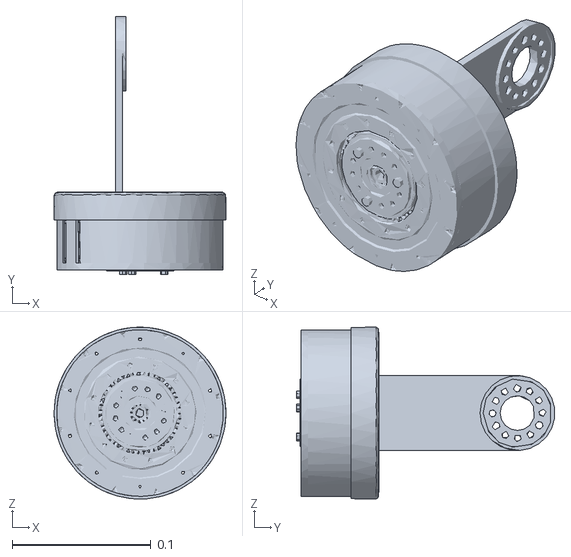
[picture p82: CAD file, 2024-12-19]
2. OpenSim逆动力学仿真/assets/Thigh-1-r.STL
0.124 x 0.186 x 0.124
