lurejewel/-/1. 机械结构/先进机器人控制大模型/铜柱.SLDPRT

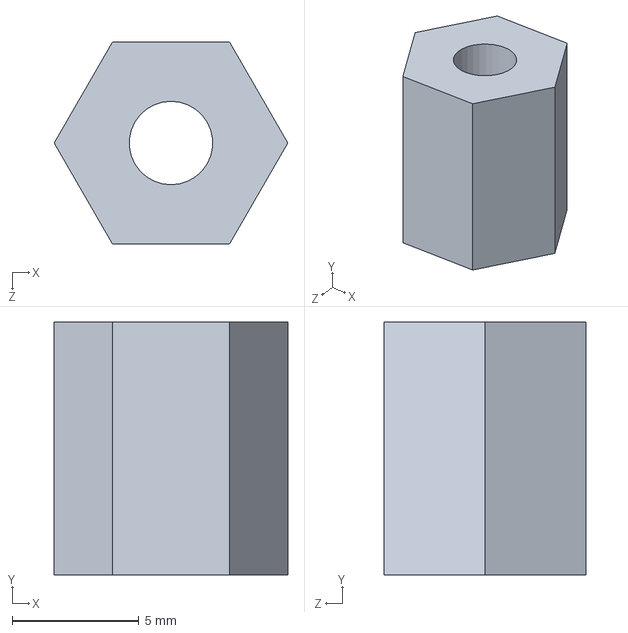
[picture p83: CAD file, 2024-12-26]
1. 机械结构/先进机器人控制大模型/铜柱.SLDPRT
9.24 x 10.0 x 8.00 mm
