lurejewel/-/2. OpenSim逆动力学仿真/assets/Pelvis.STL

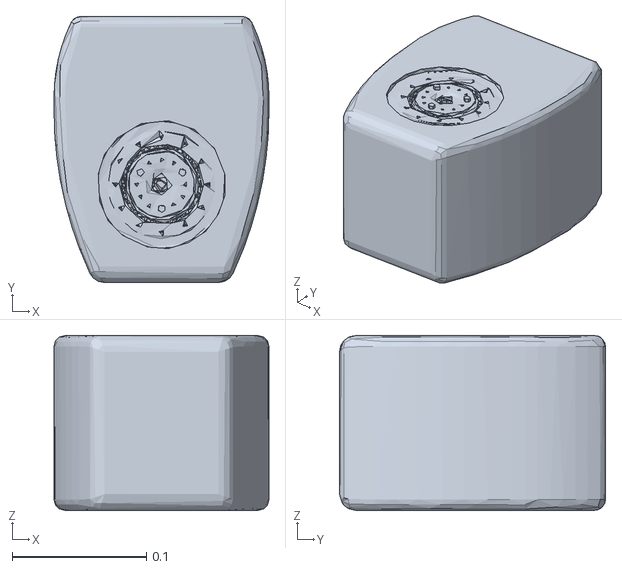
[picture p84: CAD file, 2024-12-19]
2. OpenSim逆动力学仿真/assets/Pelvis.STL
0.16 x 0.198 x 0.131
