lurejewel/-/3. ANSYS仿真/63LBBBL1A-LG-17_配置A.STEP

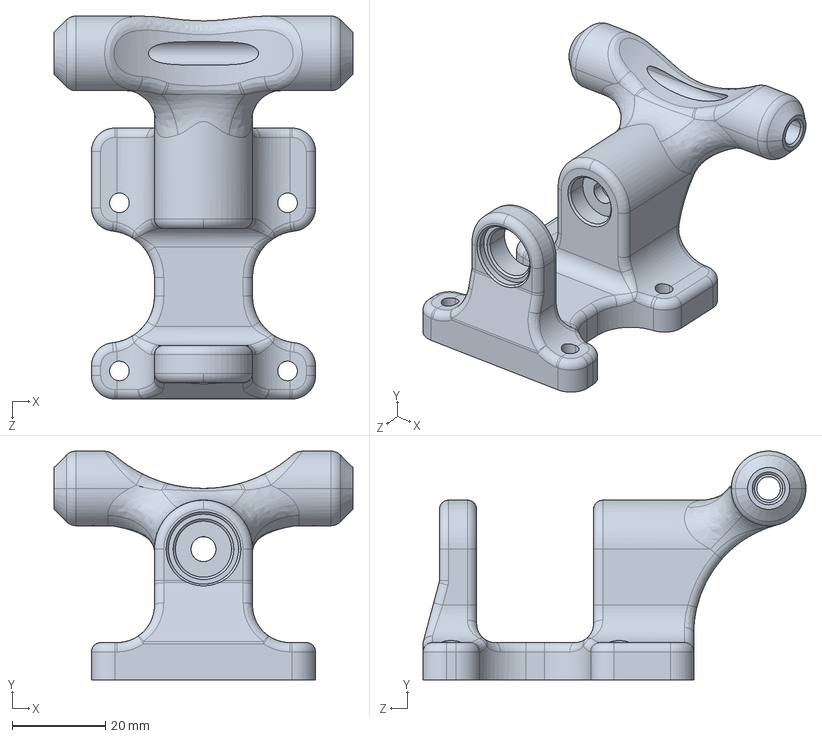
[picture p85: CAD file, 2024-12-19]
3. ANSYS仿真/63LBBBL1A-LG-17_配置A.STEP
64.0 x 49.0 x 82.0 mm
