lurejewel/-/2. OpenSim逆动力学仿真/assets/Foot-l.STL

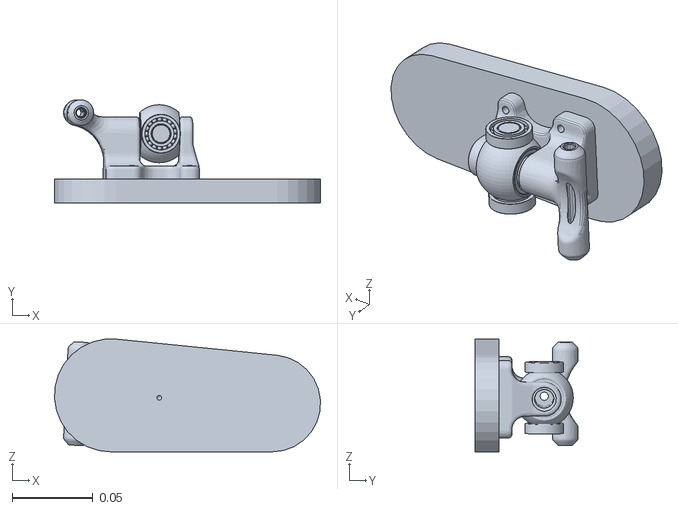
[picture p86: CAD file, 2024-12-19]
2. OpenSim逆动力学仿真/assets/Foot-l.STL
0.165 x 0.064 x 0.0698
