lurejewel/-/3. ANSYS仿真/63LBB大腿旋转电机座.STEP

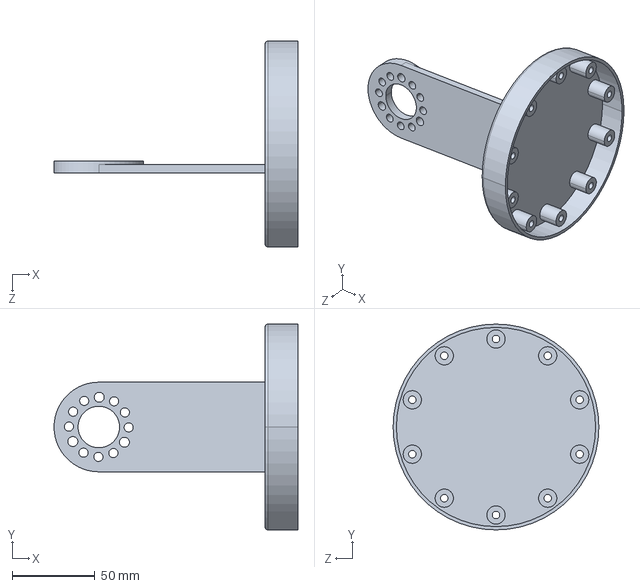
[picture p87: CAD file, 2024-12-19]
3. ANSYS仿真/63LBB大腿旋转电机座.STEP
147.0 x 124.0 x 124.0 mm
