lurejewel/-/1. 机械结构/先进机器人控制大模型/板子1号.SLDPRT

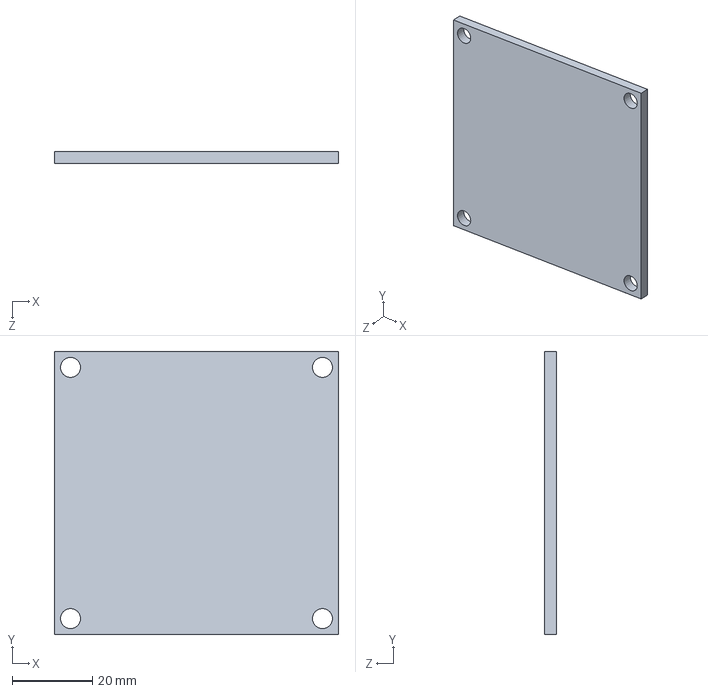
[picture p88: CAD file, 2024-12-26]
1. 机械结构/先进机器人控制大模型/板子1号.SLDPRT
70.9 x 70.7 x 3.00 mm
