lurejewel/-/2. OpenSim逆动力学仿真/assets/HAT-pelvis.STL

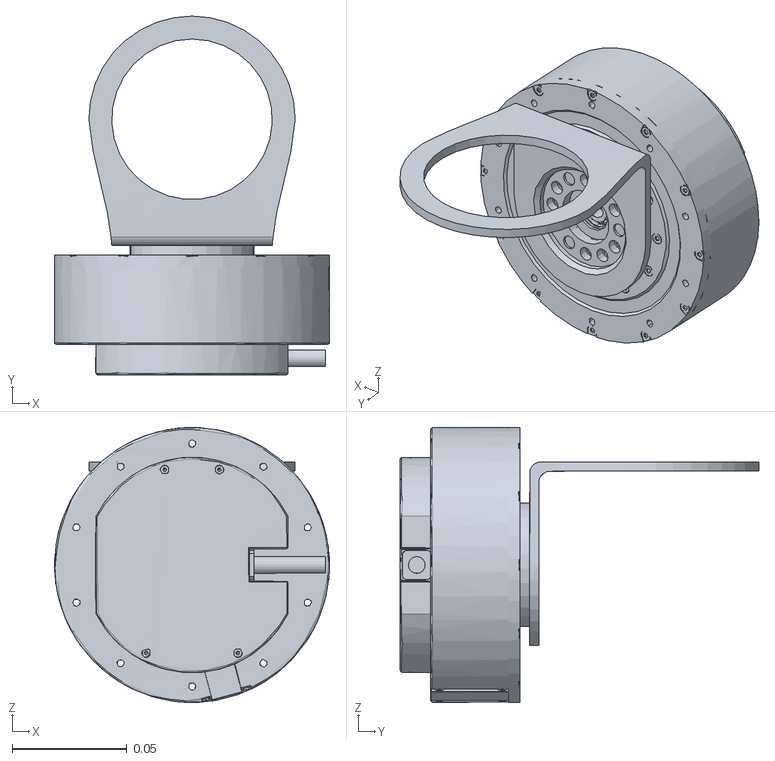
[picture p89: CAD file, 2024-12-19]
2. OpenSim逆动力学仿真/assets/HAT-pelvis.STL
0.12 x 0.156 x 0.12
