lurejewel/-/2. OpenSim逆动力学仿真/assets/Thigh-2-l.STL

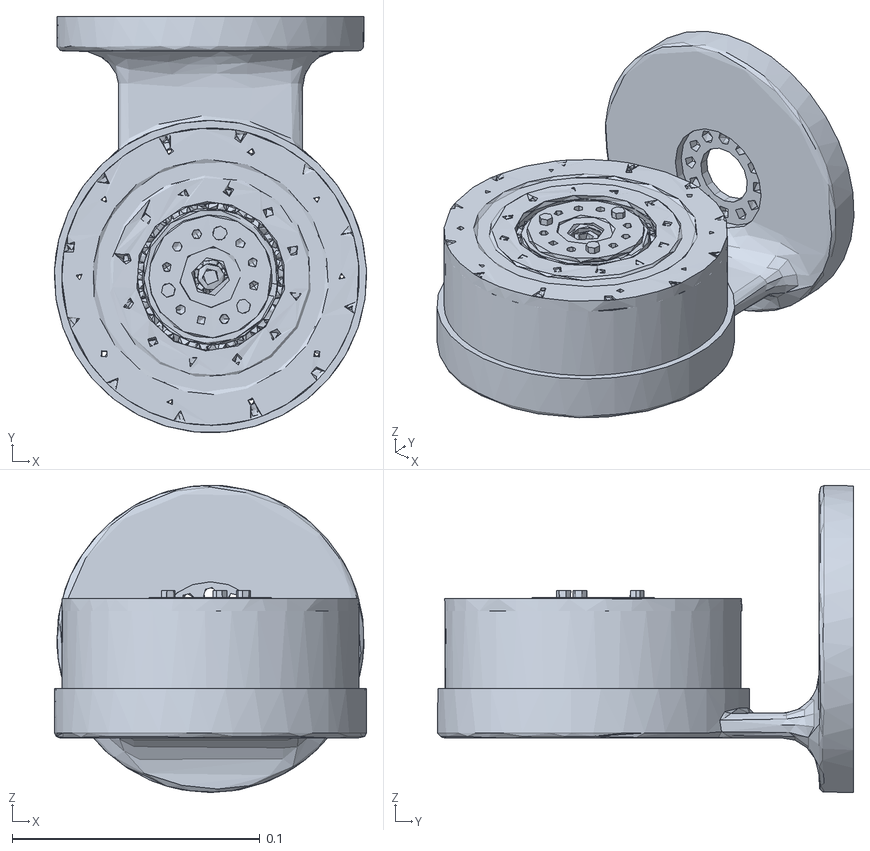
[picture p90: CAD file, 2024-12-19]
2. OpenSim逆动力学仿真/assets/Thigh-2-l.STL
0.126 x 0.168 x 0.124
