lurejewel/-/3. ANSYS仿真/63LBB头.STEP

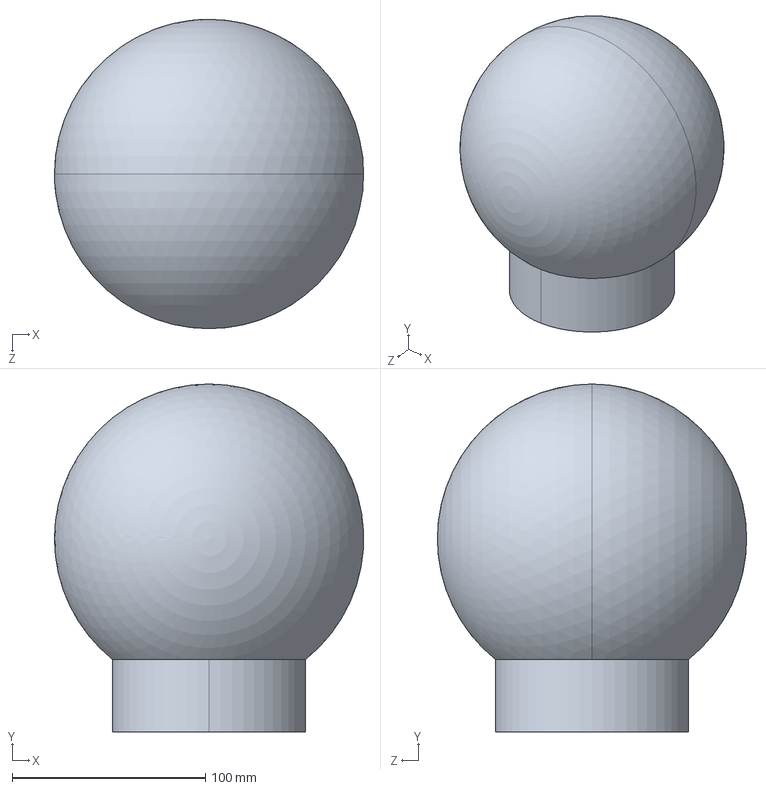
[picture p91: CAD file, 2024-12-19]
3. ANSYS仿真/63LBB头.STEP
159.9 x 180.0 x 160.0 mm
