lurejewel/-/3. ANSYS仿真/63LBBBL1A-LG-18_配置A.STEP

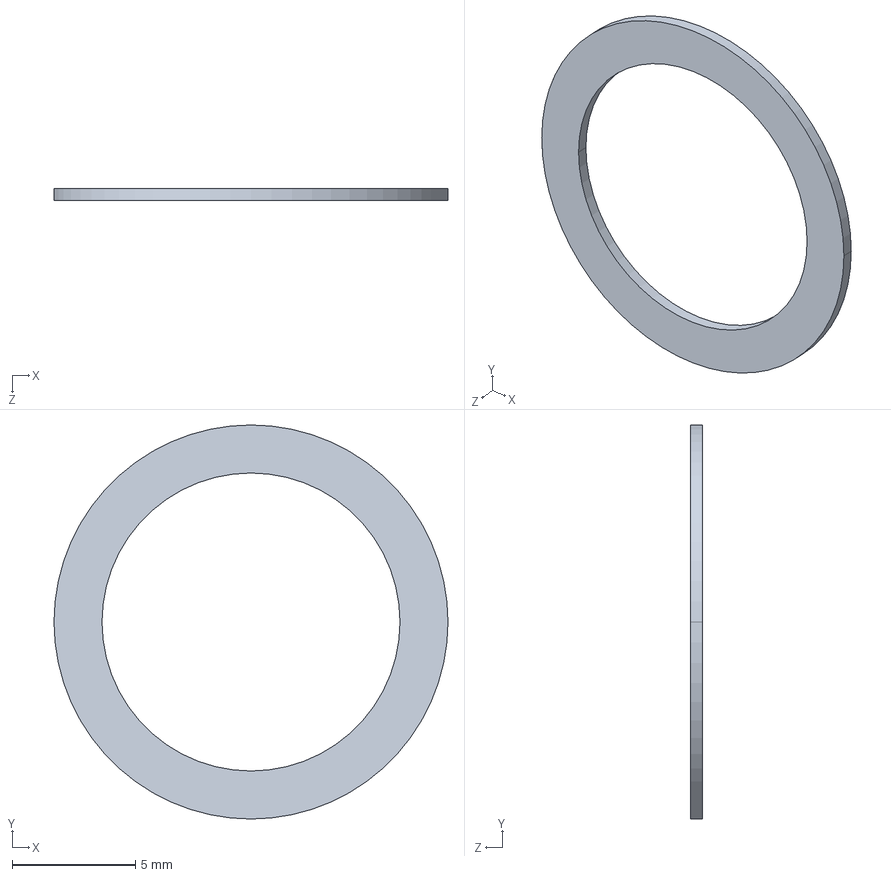
[picture p92: CAD file, 2024-12-19]
3. ANSYS仿真/63LBBBL1A-LG-18_配置A.STEP
16.0 x 16.0 x 0.5 mm
