lurejewel/-/3. ANSYS仿真/63LBBmodel_ph14b.STEP

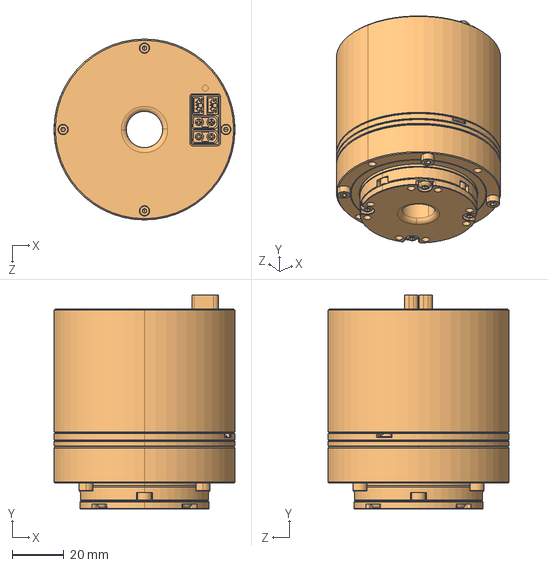
[picture p93: CAD file, 2024-12-19]
3. ANSYS仿真/63LBBmodel_ph14b.STEP
70.0 x 82.8 x 70.0 mm
