lurejewel/-/3. ANSYS仿真/63右腿右外壳A.STEP

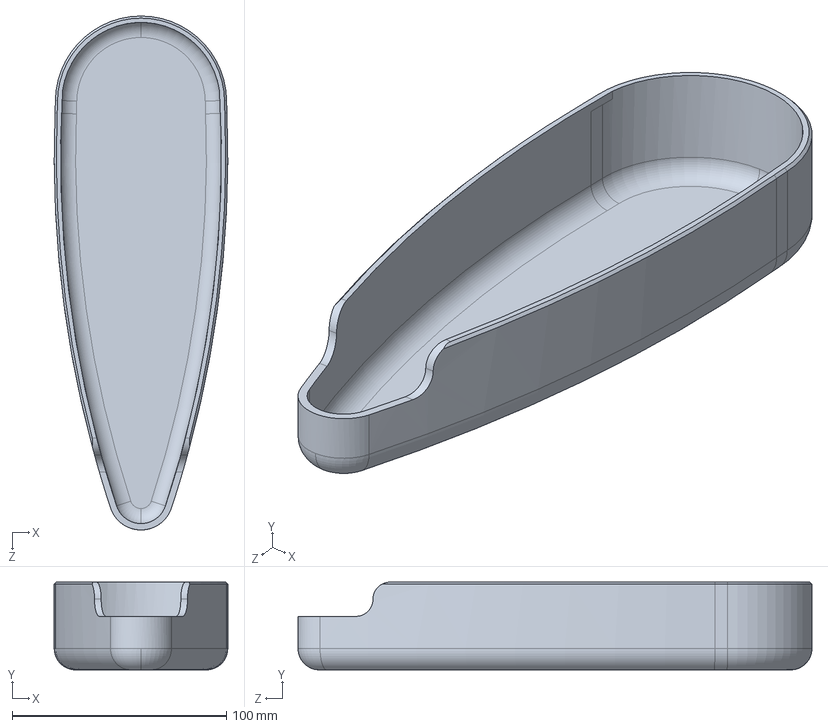
[picture p94: CAD file, 2024-12-19]
3. ANSYS仿真/63右腿右外壳A.STEP
81.1 x 41.0 x 240.0 mm
