lurejewel/-/3. ANSYS仿真/63LBB膝关节电机座.STEP

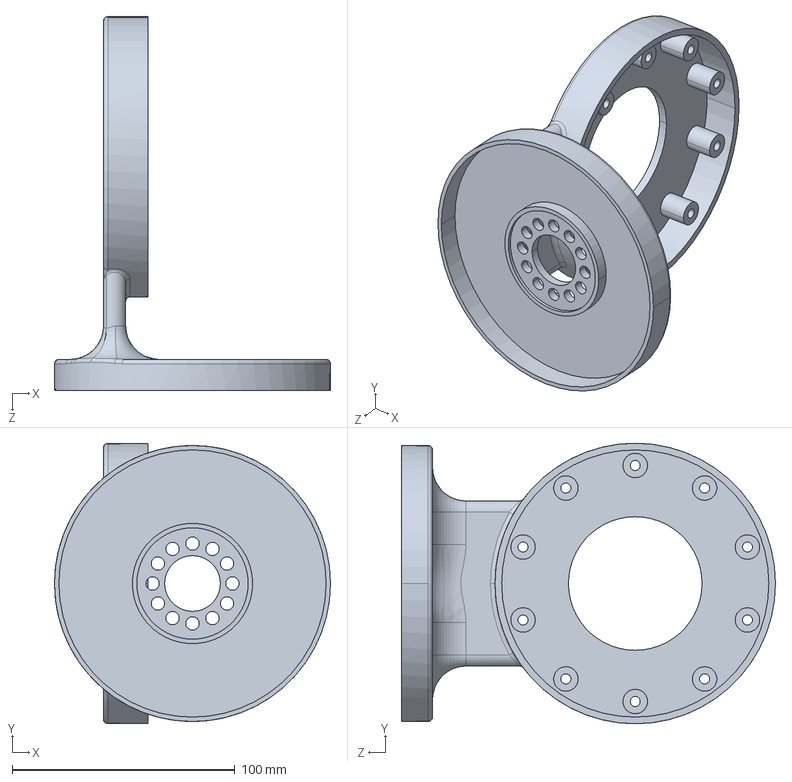
[picture p95: CAD file, 2024-12-19]
3. ANSYS仿真/63LBB膝关节电机座.STEP
124.0 x 126.0 x 168.0 mm
