lurejewel/-/3. ANSYS仿真/63LBB侧摆电机座.STEP

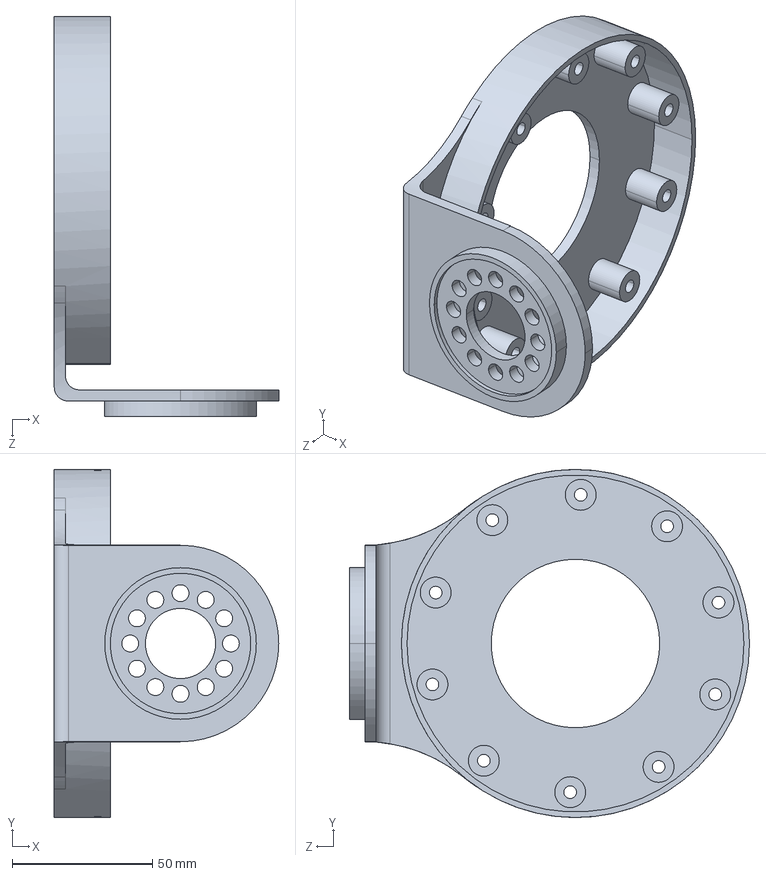
[picture p96: CAD file, 2024-12-19]
3. ANSYS仿真/63LBB侧摆电机座.STEP
80.0 x 124.0 x 142.5 mm
