lurejewel/-/3. ANSYS仿真/63LBB侧摆电机座 - yao.STEP

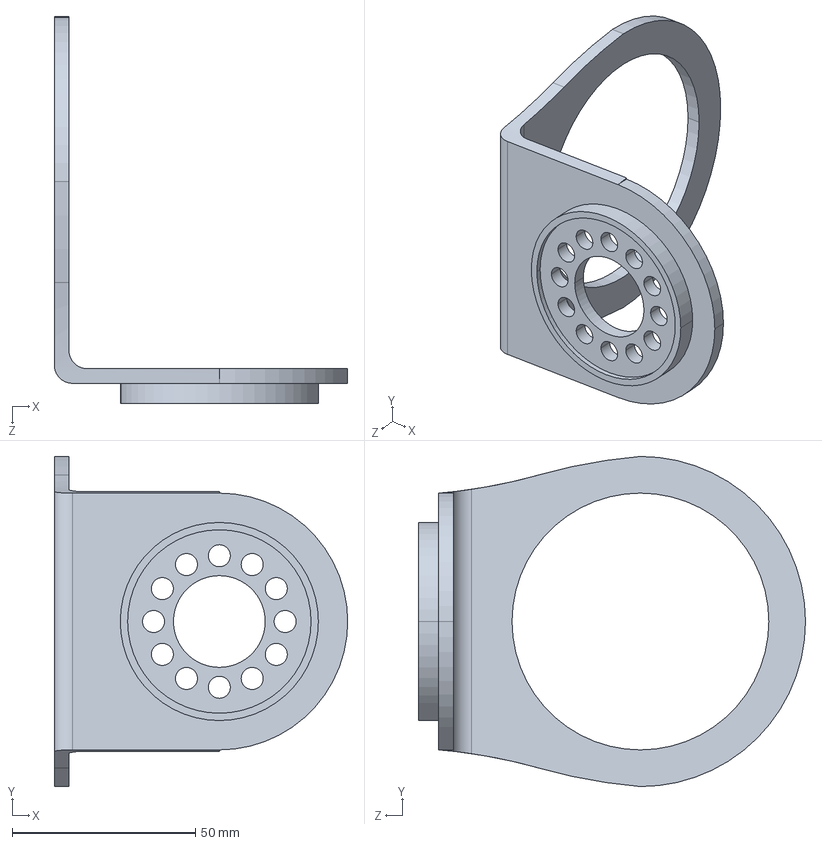
[picture p97: CAD file, 2024-12-19]
3. ANSYS仿真/63LBB侧摆电机座 - yao.STEP
80.0 x 90.0 x 105.5 mm
