lurejewel/-/3. ANSYS仿真/63LBBBL1A-LG-19_配置A.STEP

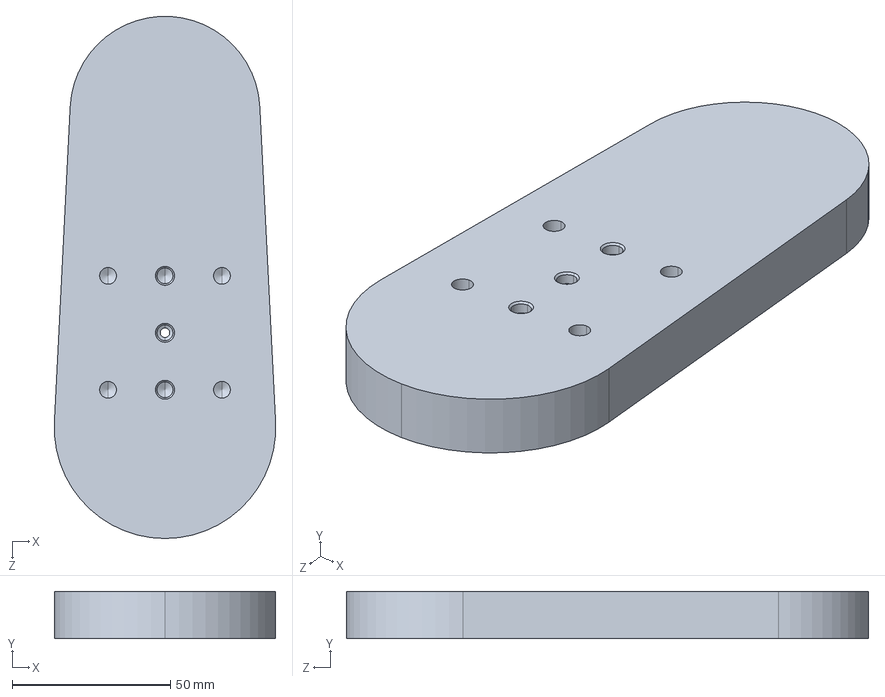
[picture p98: CAD file, 2024-12-19]
3. ANSYS仿真/63LBBBL1A-LG-19_配置A.STEP
69.9 x 15.0 x 164.9 mm
