lurejewel/-/3. ANSYS仿真/63LBB人形箱体.STEP

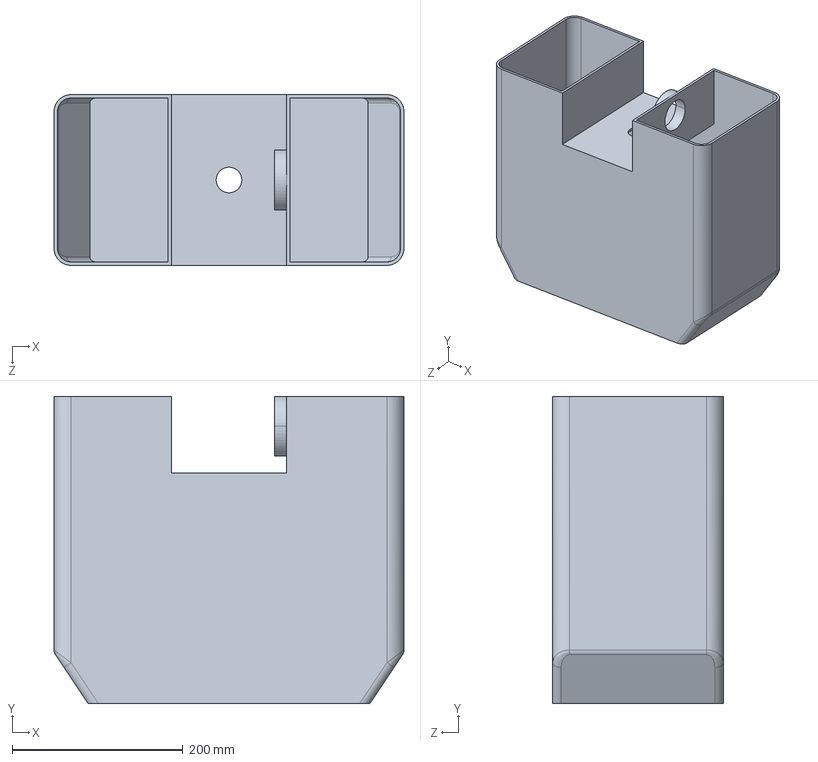
[picture p99: CAD file, 2024-12-19]
3. ANSYS仿真/63LBB人形箱体.STEP
410.0 x 360.0 x 200.0 mm
