lurejewel/-/3. ANSYS仿真/63LBB中间电机座.STEP

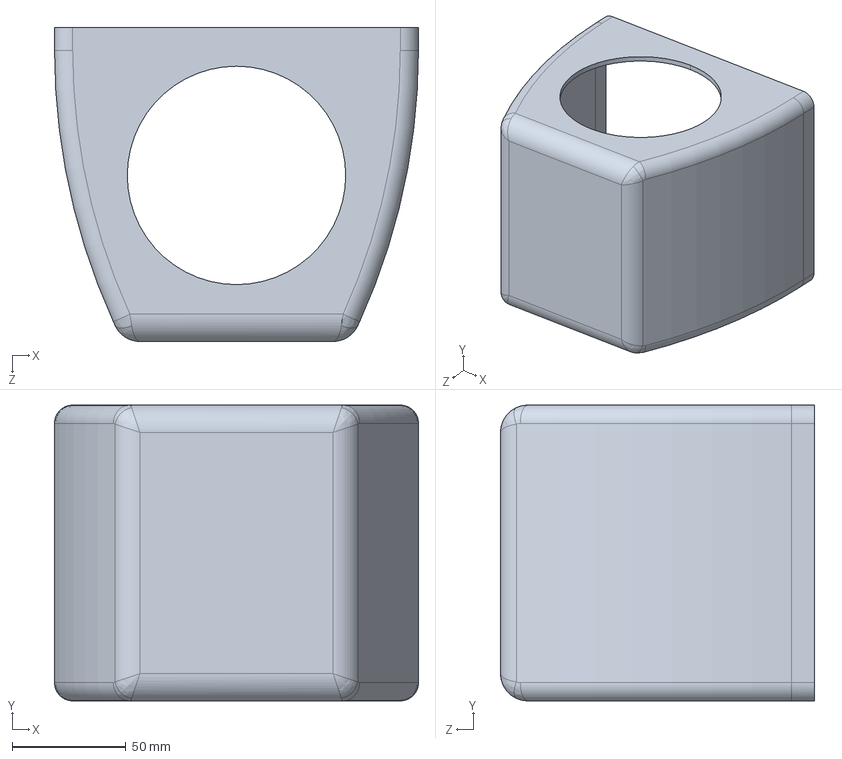
[picture p100: CAD file, 2024-12-19]
3. ANSYS仿真/63LBB中间电机座.STEP
160.0 x 130.0 x 138.0 mm
