lurejewel/-/3. ANSYS仿真/63LBBBL1A-LG-15_配置A.STEP

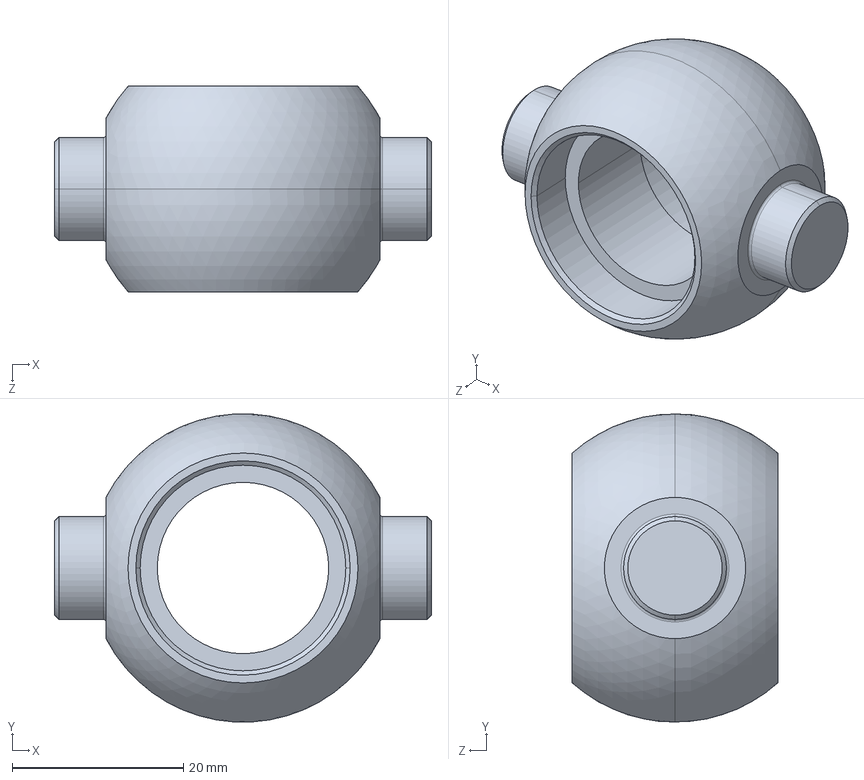
[picture p101: CAD file, 2024-12-19]
3. ANSYS仿真/63LBBBL1A-LG-15_配置A.STEP
44.0 x 35.9 x 24.0 mm
