lurejewel/-/(list of files, cad)

Other CAD files:
3. ANSYS仿真/装配体8^test.STEP
3. ANSYS仿真/装配体18^test.STEP
3. ANSYS仿真/装配体14^test.STEP
3. ANSYS仿真/装配体10^test.STEP
1. 机械结构/先进机器人控制大模型/镜向左大胸.SLDPRT
2. OpenSim逆动力学仿真/assets/Thigh-1-l.STL
3. ANSYS仿真/装配体17^test.STEP
2. OpenSim逆动力学仿真/assets/Foot-r.STL
3. ANSYS仿真/装配体16^test.STEP
2. OpenSim逆动力学仿真/assets/Pelvis-thigh-l.STL
3. ANSYS仿真/装配体19^test.STEP
2. OpenSim逆动力学仿真/assets/Thigh-2-r.STL
3. ANSYS仿真/装配体11^test.STEP
3. ANSYS仿真/装配体3^test.STEP
3. ANSYS仿真/装配体15^test.STEP
3. ANSYS仿真/装配体9^test.STEP
3. ANSYS仿真/装配体7^test.STEP
3. ANSYS仿真/装配体13^test.STEP
3. ANSYS仿真/63LBB中间电机座 - 副本.STEP
