lurejewel/-/(commit log)

2024-12-19 添加去年作业参考
2024-12-19 add STEP files in ANSYS sub-project
    [63LBBBBearing6901_配置A.STEP, 63LBBBL1A-LG-15_配置A.STEP, 63LBBBL1A-LG-17_配置A.STEP, 63LBBBL1A-LG-18_配置A.STEP, 63LBBBL1A-LG-19_配置A.STEP, 63LBBmodel_ph14b.STEP, 63LBB中间电机座 - 副本.STEP, 63LBB中间电机座.STEP]
2024-12-26 update OpenSim ik; update MATLAB dynamics simulation
    [你想看什么表情我都有.SLDPRT, 大合体.SLDASM, 左大胸.SLDPRT, 机器人也有大胸脯.SLDPRT, 板子1号.SLDPRT, 板子2号.SLDPRT, 板子3号.SLDPRT, 铜柱.SLDPRT]
